LoganDickon/FilterCheck/README.md

# FilterCheck
This repository contains all required documents on the "FilterCheck"

Created: 5/3/2022                                                                                                                                                        
Property of AtorLabs
