LoganDickon/FilterCheck/Documents/README.md

# This folder contains "FilterCheck Documents" (.XLSX, .DOC)
