LoganDickon/FilterCheck/Mechanical/Interface Panel Decal/readme.md

# This Folder contains the FilterCheck interface panel decal
