LoganDickon/FilterCheck/Mechanical/Machine Shop Files/readme.md

# This folder contains the file for the FilterCheck interface panel cutout
