LoganDickon/FilterCheck/Documents/FilterCheck - Electric Schematics (Title Page).docx

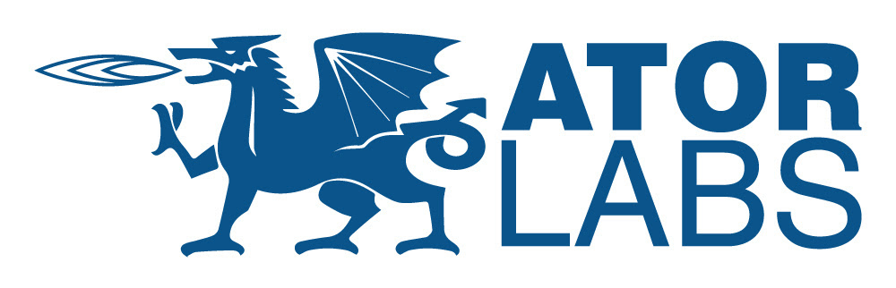
[picture p1: figure]

Memo 111422

FilterCheck

Electrical Schematics

7506 Holley Circle

Panama City Beach, FL 32408

November 14^t^h, 2022

# Revision Table

Date | Revision Number | Change Description | Job Title | Initials
11/14/2022 | 0 | Document Created | Electrical Engineer | JAD
