LoganDickon/FilterCheck/Documents/FilterCheck - Software (Title Page).docx

SFC 112222

FilterCheck

Software Flow Chart

7506 Holley Circle

Panama City Beach, FL 32408

November 22nd, 2022

# Revision Table

Date | Revision Number | Change Description | Job Title | Initials
10/19/2022 | 0 | Document Created | Software Engineer | LAD

Rev 0 Page 3

SFC 112222 ATOR LABS
