LoganDickon/FilterCheck/Mechanical/README.md

# This folder contains all FilterCheck Mechanical Documentation!

Created: 5/3/2022                                                                                                                                                         
Developers: Ben Morrisey (Mechanical Engineer) & Jake Cornman (Mechanical Engineer)                                                                                       
Property of AtorLabs
