LoganDickon/FilterCheck/Electrical/README.md

# This folder contains all FilterCheck Electrical Documentation!

Created: 5/3/2022                                                                                                                                                         
Developer: Jesse Dickon (Electrical Engineer)                                                                                                                           
Property of AtorLabs
