LoganDickon/FilterCheck/Software/Previous Versions/README.md

# Deprecated Arduino IDE code for the FilterCheck!
