LoganDickon/FilterCheck/Mechanical/SolidWorks Bill of Material/readme.md

# This file contains the Bill of Materials generated by SolidWorks 3D
