LoganDickon/FilterCheck/Documents/FilterCheck - Bill of Materials (Title Page).docx

Memo 10122

FilterCheck

Bill of Materials

7506 Holley Circle

Panama City Beach, FL 32408

October 1st, 2022

# Revision Table

Date | Revision Number | Change Description | Job Title | Initials
10/1/2022 | 0 | Document Created | Software Engineer | LAD
