LoganDickon/FilterCheck/Documents/FilterCheck - Bill of Materials (Printable).xlsx

ITEM NO. | A, B, or C | DEPARTMENT | PART NO. | DESCRIPTION | ASM CATEGORY | MATERIAL | MANUFACTURER | SUPPLIER | ORDER QTY. | COMP COSTS | BUILD QTY. | UNIT COST | 5 UNITS | 50 UNITS
1 | COTS | MECHANICAL | 1400 | PELICAN 1400 PROTECTOR CASE | CASE | POLYPROPYLENE | PELICAN | AMAZON | 1 | $89.92 | 1 | $89.92 | $449.60 | $4496.00
2 | COTS | MECHANICAL | 1400PF | PELICAN 1400 FRAME KIT | CASE | POLYPROPYLENE |  | MIDWEST CASE COMPANY | 1 | $26.95 | 1 | $26.95 | $134.75 | $1347.50
3 | COTS | MECHANICAL | 9307K73 | 7/8" GROMMET WITH 1-1/4" HOLE | CASE | BUNA-N RUBBER |  | MCMASTER-CARR | 25 | $12.99 | 1 | $0.52 | $2.60 | $25.98
4 | BESPOKE | MECHANICAL | FC-001 | CONTROL PANEL | CASE | ABS |  | ATOR LABS | 1 | $0.00 | 1 | $0.00 | $0.00 | $0.00
5 | BESPOKE | MECHANICAL | FC-007 | DECAL | CASE | VINYL |  | ATOR LABS | 1 | $0.00 | 1 | $0.00 | $0.00 | $0.00
6 | BESPOKE | MECHANICAL | FC-008 | CASE JIG FOR DRILLING | CASE | PLA |  | ATOR LABS | 1 | $0.00 | 1 | $0.00 | $0.00 | $0.00
7 | COTS | MECHANICAL | 99186A143 | RUBBER WASHER - 44mm OD, 25mm ID | FLOW SYSTEM | EPDM RUBBER |  | MCMASTER-CARR | 10 | $14.02 | 1 | $1.40 | $7.01 | $70.10
8 | COTS | MECHANICAL | 9540K747 | UNTHREADED BUMPER | FLOW SYSTEM | SBR RUBBER |  | MCMASTER-CARR | 10 | $6.33 | 3 | $1.90 | $9.50 | $94.95
9 | COTS | MECHANICAL | 2930T55 | STEEL WIRE CLOTH DISCS | FLOW SYSTEM | 316 STAINLESS STEEL |  | MCMASTER-CARR | 10 | $12.76 | 1 | $1.28 | $6.38 | $63.80
10 | COTS | MECHANICAL | 5300-IF-LP | TSI 5300 SERIES INLET FILTER | FLOW SYSTEM |  |  | TSI | 1 | $0.00 | 1 | $0.00 | $0.00 | $0.00
11 | COTS | MECHANICAL | 5233K52 | SOFT TUBING - 50 ft | FLOW SYSTEM | PVC Plastic |  | MCMASTER-CARR | 1 | $11.00 | 0.03 | $0.33 | $1.65 | $16.50
12 | COTS | MECHANICAL | 9561K16 | -015 ORING, BUNA-N | FLOW SYSTEM | EPDM |  | MCMASTER-CARR | 25 | $2.86 | 1 | $0.11 | $0.57 | $5.72
13 | COTS | MECHANICAL | 9561K24 | -022 ORING | FLOW SYSTEM | EPDM |  | MCMASTER-CARR | 10 | $1.97 | 1 | $0.20 | $0.99 | $9.85
14 | COTS | ELECTRICAL | JYQD_V7.3E2 | 24v BLOWER CONTROL BOARD | FLOW SYSTEM |  | EBAY | TOP_ELECTRONIC1980_TECHWIN | 1 | $17.19 | 1 | $17.19 | $85.95 | $859.50
15 | COTS | ELECTRICAL | U65ML-024KS-5 | MICRONEL 250 LPM BLDC BLOWER | FLOW SYSTEM |  | MICRONEL | DIGIKEY | 1 | $98.00 | 1 | $98.00 | $490.00 | $4900.00
16 | COTS | ELECTRICAL | 5310-2 | TSI 5310 FLOW METER | FLOW SYSTEM | POLYCARBONATE |  | TSI | 1 | $0.00 | 1 | $0.00 | $0.00 | $0.00
17 | COTS | ELECTRICAL | LR4P-USBMF | USB 3.0 ADAPTER | FLOW SYSTEM |  | WARMSTOR | AMAZON | 4 | $8.99 | 1 | $2.25 | $11.24 | $112.38
18 | COTS | ELECTRICAL | B07VJNQT6F | LOW PROFILE USB-C CABLE | FLOW SYSTEM |  | UGREEN | AMAZON | 1 | $8.49 | 1 | $8.49 | $42.45 | $424.50
19 | COTS | ELECTRICAL | B07RX7Z9ZW | 36 Pins .5mm Pitch 150mm FPC FFC | FLOW SYSTEM | PLASTIC | UXCELL | AMAZON | 5 | $6.99 | 1 | 1.398 | 6.99 | 69.9
20 | COTS | ELECTRICAL | a19042900ux0610 | 36 Pins to 36 Pins Extension Adapter .5mm Pitch | FLOW SYSTEM | PLASTIC | UXCELL | UXCELL | 1 | $5.99 | 1 | 5.99 | 29.95 | 299.5
21 | BESPOKE | MECHANICAL | FC-003 | PITOT TOP | FLOW SYSTEM | SLA |  | ATOR LABS | 1 | $0.00 | 1 | $0.00 | $0.00 | $0.00
22 | BESPOKE | MECHANICAL | FC-004 | PITOT BOTTOM | FLOW SYSTEM | SLA/PLA |  | ATOR LABS | 1 | $0.00 | 1 | $0.00 | $0.00 | $0.00
23 | BESPOKE | MECHANICAL | FC-005 | ADAPTER, BLDC FAN TO FILTER | FLOW SYSTEM | SLA |  | ATOR LABS | 1 | $0.00 | 1 | $0.00 | $0.00 | $0.00
24 | BESPOKE | MECHANICAL | FC-006 | VERIFICATION ORIFICE A | FLOW SYSTEM | SLA |  | ATOR LABS | 1 | $0.00 | 1 | $0.00 | $0.00 | $0.00
25 | BESPOKE | MECHANICAL | FC-009 | DISPLAY HOLDER | FLOW SYSTEM | SLA |  | ATOR LABS | 1 | $0.00 | 1 | $0.00 | $0.00 | $0.00
26 | COTS | ELECTRICAL | 7395K11 | ROCKER POWER SWITCH | POWER | PLASTIC |  | MCMASTER-CARR | 1 | $7.50 | 1 | $7.50 | $37.50 | $375.00
27 | COTS | ELECTRICAL | 9397K15 | SOLDER-LOADED HEAT-SHRINK QUICK-DISCONNECT TERMINALS | POWER | POLYOLEFIN |  | MCMASTER-CARR | 10 | $13.40 | 2 | $2.68 | $13.40 | $134.00
28 | COTS | ELECTRICAL | B08P5PJBCM | 5.5MM X 2.1MM DC JACK, POWER INLET | POWER |  | QOFOWIN | AMAZON | 5 | $8.99 | 1 | $1.80 | $8.99 | $89.90
29 | COTS | ELECTRICAL | CU-J294 | 3000 MAH LIFEPO4 BATTERY (16 X 18650 BATTERIES) OPEN END WIRES | POWER | LIFEPO4 | AA PORTABLE POWER CORP | BATTERYSPACE | 1 | $102.77 | 1 | $102.77 | $513.85 | $5138.50
30 | COTS | ELECTRICAL | OWA-60U-30 | 30V POWER SUPPLY | POWER |  | MEANWELL | TRC ELECTRONICS | 1 | $32.30 | 1 | $32.30 | $161.50 | $1615.00
31 | COTS | ELECTRICAL | PSE-24-DC12-40 | 24V POWER CONVERTER | POWER | PLASTIC RESIN | RHINO | AUTOMATION DIRECT | 1 | $80.00 | 1 | $80.00 | $400.00 | $4000.00
32 | COTS | ELECTRICAL | LTC0389-X | POWER CONVERTER, 24V TO 5V | POWER / BOARD STACK |  | TOBSUN | AMAZON | 1 | $9.59 | 1 | $9.59 | $47.95 | $479.50
33 | COTS | ELECTRICAL | B07B48CW3Y | BATTERY RELAY | POWER / BOARD STACK |  | WALFRONT | AMAZON | 1 | $9.83 | 1 | $9.83 | $49.15 | $491.50
34 | COTS | ELECTRICAL | 43201513 | TEENSY 4.1 TERMINAL BOARD | BOARD STACK |  | OONO | AMAZON | 1 | $23.90 | 1 | $23.90 | $119.50 | $1195.00
35 | COTS | ELECTRICAL | TEENSY41 | TEENSY 4.1 DEVELOPMENT BOARD | BOARD STACK |  | TEENSY | PJRC | 1 | $32.60 | 1 | $32.60 | $163.00 | $1630.00
36 | COTS | ELECTRICAL | B079FGPC9Y | 5V 2 CHANNEL RELAY MODULE | BOARD STACK |  | CHENBO | AMAZON | 2 | $8.99 | 1 | $4.50 | $22.48 | $224.75
37 | COTS | ELECTRICAL | FAFEICYA6I34V0OPM | 3.3V PWM SIGNAL TO 0-5V VOLTAGE CONVERTER | BOARD STACK |  | FAFEICY | AMAZON | 1 | $7.12 | 1 | $7.12 | $35.60 | $356.00
38 | COTS | ELECTRICAL | B08G4VCQ84 | BLUE PANEL MOUNT LED | BOARD STACK |  | CHANZON | AMAZON | 5 | $5.99 | 1 | $1.20 | $5.99 | $59.90
39 | COTS | ELECTRICAL | B08G4XRKRX | GREEN PANEL MOUNT LED | BOARD STACK |  | CHANZON | AMAZON | 5 | $5.99 | 1 | $1.20 | $5.99 | $59.90
40 | COTS | ELECTRICAL | DT-6560-1.8m | USB TO TTL SERIAL 3.3V ADAPTER CABLE | BOARD STACK |  | DTECH | AMAZON | 1 | $15.68 | 1 | $15.68 | $78.40 | $784.00
41 | BESPOKE | MECHANICAL | FC-002-1 | STACKING BOARD - MOTOR CONTROLLER & BATTERY RELAY | BOARD STACK | PLA |  | ATOR LABS | 1 | $0.00 | 1 | $0.00 | $0.00 | $0.00
42 | BESPOKE | MECHANICAL | FC-002-2 | STACKING BOARD - TEENSY 4.1 TERMINAL BOARD | BOARD STACK | PLA |  | ATOR LABS | 1 | $0.00 | 1 | $0.00 | $0.00 | $0.00
43 | BESPOKE | MECHANICAL | FC-002-3 | STACKING BOARD - PWM TO ANALOG CONVERTER | BOARD STACK | PLA |  | ATOR LABS | 1 | $0.00 | 1 | $0.00 | $0.00 | $0.00
44 | COTS | MECHANICAL | 9273K15 | VELCRO STRIPS - 5 ft | FASTENER | NYLON |  | MCMASTER-CARR | 12 | $13.73 | 0.1 | $0.11 | $0.57 | $5.72
45 | COTS | MECHANICAL | 91771A943 | FLAT HEAD SCREW - #6-32x7/16" | FASTENER | 18-8 STAINLESS STEEL |  | MCMASTER-CARR | 100 | $10.64 | 10 | $1.06 | $5.32 | $53.20
46 | COTS | MECHANICAL | 98952A120 | M/F STANDOFF - M3x25mm + 5mm | FASTENER | ALUMINUM |  | MCMASTER-CARR | 1 | $2.24 | 3 | $6.72 | $33.60 | $336.00
47 | COTS | MECHANICAL | 95947A063 | F STANDOFF - M3x31MM | FASTENER | AL 6061-T6 |  | MCMASTER-CARR | 1 | $2.23 | 4 | $8.92 | $44.60 | $446.00
48 | COTS | MECHANICAL | 93657A207 | SPACER - M3x5mm | FASTENER | NYLON 6/6 PLASTIC |  | MCMASTER-CARR | 1 | $1.39 | 4 | $5.56 | $27.80 | $278.00
49 | COTS | MECHANICAL | 93475A210 | WASHER - M3 | FASTENER | 18-8 STAINLESS STEEL |  | MCMASTER-CARR | 100 | $2.19 | 4 | $0.09 | $0.44 | $4.38
50 | COTS | MECHANICAL | B073XP7MZ6 | M/F STANDOFF - M3x10mm + 6mm | FASTENER | BRASS | SAMIDEA | AMAZON | 50 | $6.99 | 10 | $1.40 | $6.99 | $69.90
51 | COTS | MECHANICAL | 95947A510 | F STANDOFF - M3x13mm | FASTENER | ALUMINUM |  | MCMASTER-CARR | 1 | $1.15 | 2 | $2.30 | $11.50 | $115.00
52 | COTS | MECHANICAL | B09V2936PG | F STANDOFF - M3x15mm | FASTENER | BRASS | PRIAOLKER | AMAZON | 20 | $5.99 | 4 | $1.20 | $5.99 | $59.90
53 | COTS | MECHANICAL | B09NDGJC3F | F STANDOFF - M3x20mm | FASTENER | BRASS | PRIAOLKER | AMAZON | 20 | $7.99 | 2 | $0.80 | $4.00 | $39.95
54 | COTS | MECHANICAL | 95947A527 | F STANDOFF - M3x24mm | FASTENER | ALUMINUM |  | MCMASTER-CARR | 1 | $1.85 | 8 | $14.80 | $74.00 | $740.00
55 | COTS | MECHANICAL | 91828A211 | HEX NUT - M3 | FASTENER | 18-8 STAINLESS STEEL |  | MCMASTER-CARR | 100 | $4.73 | 6 | $0.28 | $1.42 | $14.19
56 | COTS | MECHANICAL | 90116A153 | PAN HEAD SCREW - M3x8mm | FASTENER | 316 STAINLESS STEEL |  | MCMASTER-CARR | 100 | $13.24 | 16 | $2.12 | $10.59 | $105.92
57 | COTS | MECHANICAL | 90116A157 | PAN HEAD SCREW - M3x12mm | FASTENER | 316 STAINLESS STEEL |  | MCMASTER-CARR | 100 | $11.52 | 6 | $0.69 | $3.46 | $34.56
58 | COTS | MECHANICAL | 92010A118 | FLAT HEAD SCREW - M3x8mm | FASTENER | 18-8 STAINLESS STEEL |  | MCMASTER-CARR | 100 | $5.52 | 16 | $0.88 | $4.42 | $44.16
59 | COTS | MECHANICAL | 92010A122 | FLAT HEAD SCREW - M3x12mm | FASTENER | 18-8 STAINLESS STEEL |  | MCMASTER-CARR | 100 | $6.04 | 16 | $0.97 | $4.83 | $48.32
60 | BESPOKE | MECHANICAL | FC-010 | MOLD FOR BLDC INLET GASKET - 1" OD | RAW MATERIALS | SILICONE |  | ATOR LABS | 1 | $0.00 | 1 | $0.00 | $0.00 | $0.00
61 | BESPOKE | MECHANICAL | FC-011 | MOLD FOR FLOW METER OUTLET PLUG | RAW MATERIALS | SILICONE |  | ATOR LABS | 1 | $0.00 | 1 | $0.00 | $0.00 | $0.00
62 | COTS | MECHANICAL | 8586K261 | SHEET OF ABS 24" x 48" | RAW MATERIALS | ABS |  | MCMASTER-CARR | 1 | $30.30 | 2 | $60.60 | $303.00 | $3030.00
63 | COTS | MECHANICAL | B08T1HSPM2 | 1 KG BOTTLE OF SLA RESIN | RAW MATERIALS | SLA | ELEGOO | AMAZON | 1 | $24.99 | 0.5 | $12.49 | $62.47 | $624.75
64 | COTS | ELECTRICAL | CAB-14574 | OPEN-LEADED 2-WIRE MOLEX CONNECTOR | RAW MATERIALS | WIRE | CAB-14574 | DIGIKEY | 1 | $1.06 | 1 | $1.06 | $5.30 | $53.00
65 | COTS | ELECTRICAL | CAB-14575 | OPEN-LEADED 3-WIRE MOLEX CONNECTOR | RAW MATERIALS | WIRE | CAB-14575 | DIGIKEY | 1 | $1.56 | 1 | $1.56 | $7.80 | $78.00
66 | COTS | MECHANICAL | PLA175BK1000 | 1 KG SPOOL OF PLA | RAW MATERIALS | PLA | AMAZON BASICS | AMAZON | 1 | $22.76 | 0.5 | $11.38 | $56.90 | $569.00
67 | COTS | ELECTRICAL | SW16A252008F25C5_RBWBBG | 16-GAUGE WIRE, RED BLACK WHITE BLUE GREEN, 25FT EA | RAW MATERIALS | WIRE | BNTECHGO | AMAZON | 1 | $35.98 | 1 | $35.98 | $179.90 | $1799.00
68 | COTS | ELECTRICAL | SW22A60008F30C10 | 22-GAUGE WIRE, 10 COLORS, 30FT EA | RAW MATERIALS | WIRE | BNTECHGO | AMAZON | 1 | $25.98 | 1 | $25.98 | $129.90 | $1299.00
69 | COTS | MECHANICAL | B09J22NWMF | 1-1/4" FORSTNER DRILL BIT | TOOLING | STEEL | BAIDETS | AMAZON | 1 | $13.58 | 1 | $13.58 | $13.58 | $13.58
70 | COTS | MECHANICAL | ‎FSF-004110 | 11mm or 27/64" DRILL BIT | TOOLING |  | FISCH | AMAZON | 1 | $5.99 | 1 | $5.99 | $5.99 | $5.99
 |  |  |  |  |  |  |  |  |  | COMP TOTAL |  | UNIT TOTAL | 5 UNITS | 50 UNITS
 |  |  |  |  |  |  |  |  |  | $929.17 |  | $785.54 | $3927.71 | $39277.08
 |  |  |  |  | `
