LoganDickon/FilterCheck/Mechanical/SolidWorks Assembly Files/FC-ControlBoardStackAsm.SLDASM

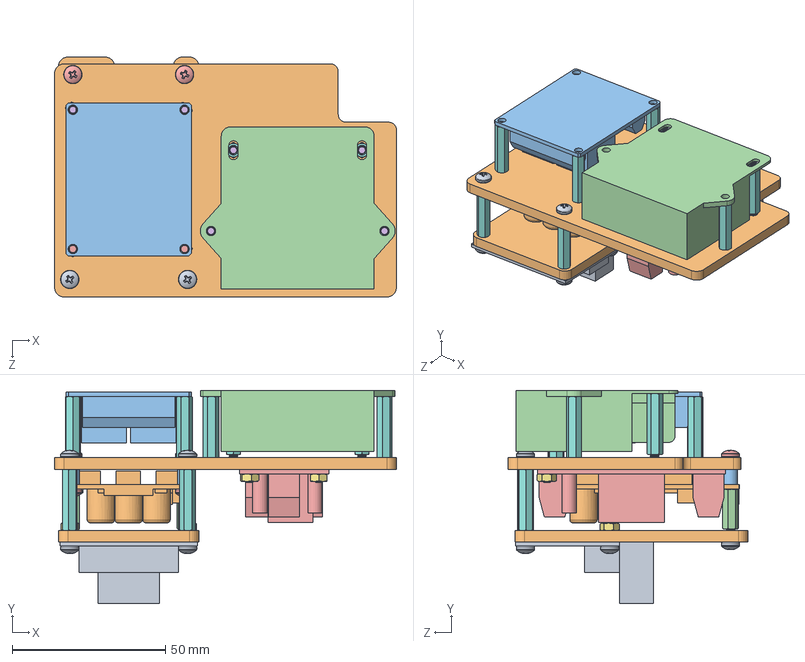
[picture p2: CAD file, 2022-12-27]
Mechanical/SolidWorks Assembly Files/FC-ControlBoardStackAsm.SLDASM
111.8 x 69.7 x 78.5 mm
FC-002_STACKING BOARDS x 2
JDQ_2 channel relay
LTC0389-X_Tobsun 24V to 5V
B07B48CW3Y_Walfront_Battery Relay
92010A118_Passivated 18-8 Stainless Steel Phillips Flat Head Screw x 8
91828A211_18-8 Stainless Steel Hex Nut x 4
Fafeicya6i34v0opm_PWM to Analog
95947A016_McMaster_M3 x 20mm standoff x 10
90116A153_McMaster_M3 x 8mm Screws x 8
TF037-1001-D_Nidec_Blower Control Board
93657A207_McMaster_M3 x 5mm Spacer x 4
95947A510_McMaster_M3 x 13mm spacer x 2
90116A157_316 Stainless Steel Pan Head Phillips Screws x 4
