LoganDickon/FilterCheck/Mechanical/stuff/DC Power Plug 2.1x5.5mm ASSY.SLDPRT

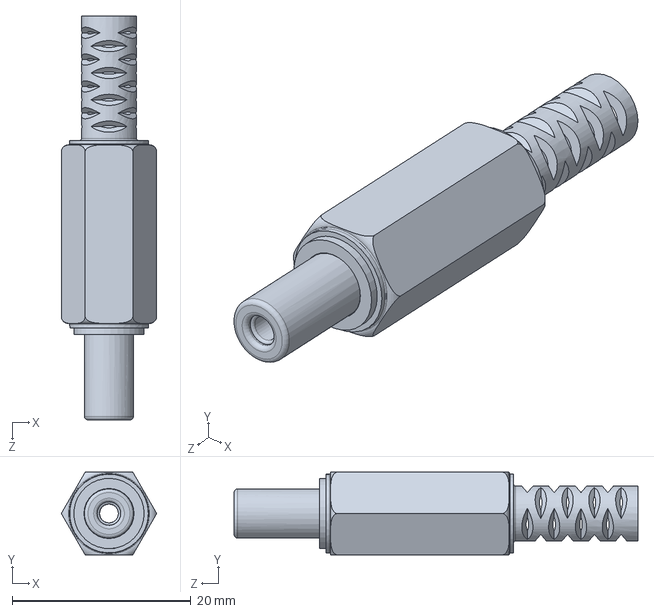
[picture p3: CAD file, 2022-12-27]
Mechanical/stuff/DC Power Plug 2.1x5.5mm ASSY.SLDPRT
10.7 x 9.25 x 45.2 mm
