LoganDickon/FilterCheck/Mechanical/stuff/FC-004_Micronel CLAMP PLATE.SLDPRT

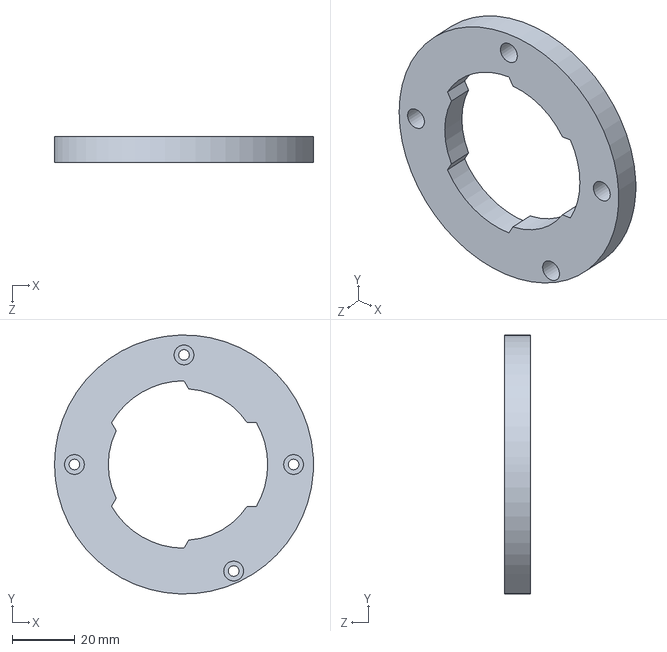
[picture p4: CAD file, 2022-12-27]
Mechanical/stuff/FC-004_Micronel CLAMP PLATE.SLDPRT
82.5 x 82.5 x 8.26 mm
