LoganDickon/FilterCheck/Mechanical/SolidWorks Part Files/B08P5PJBCM_Qofowin_5_5mm x 2_1mm DC jack.SLDPRT

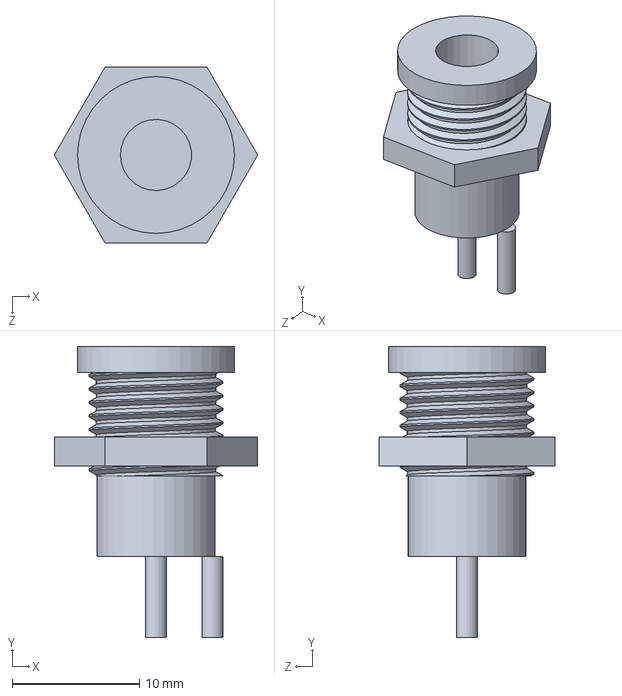
[picture p5: CAD file, 2022-12-27]
Mechanical/SolidWorks Part Files/B08P5PJBCM_Qofowin_5_5mm x 2_1mm DC jack.SLDPRT
16.0 x 22.9 x 13.8 mm
