LoganDickon/FilterCheck/Mechanical/stuff/Display.SLDPRT

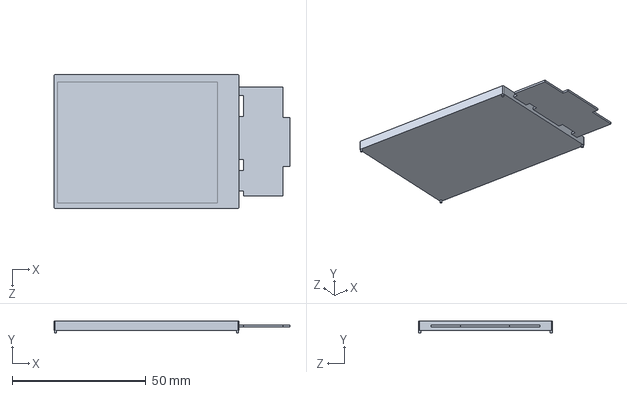
[picture p6: CAD file, 2022-12-27]
Mechanical/stuff/Display.SLDPRT
88.1 x 4.32 x 49.9 mm
