LoganDickon/FilterCheck/Mechanical/stuff/U65ML-024KS-5_Simple.SLDPRT

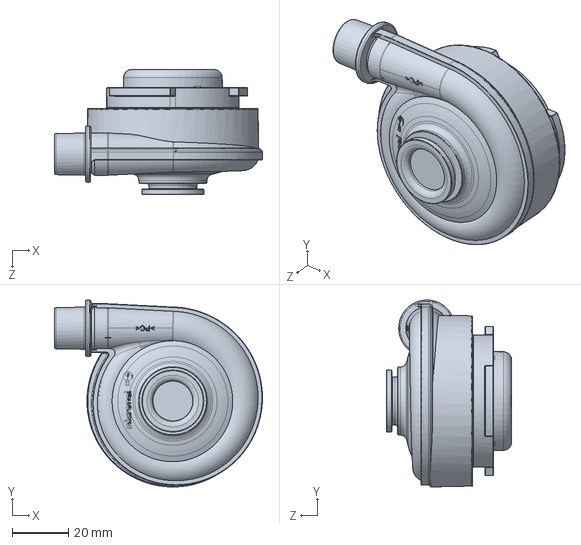
[picture p7: CAD file, 2022-12-27]
Mechanical/stuff/U65ML-024KS-5_Simple.SLDPRT
73.8 x 66.3 x 44.5 mm
