LoganDickon/FilterCheck/Mechanical/stuff/USB 3_0 Angle Adapter.SLDPRT

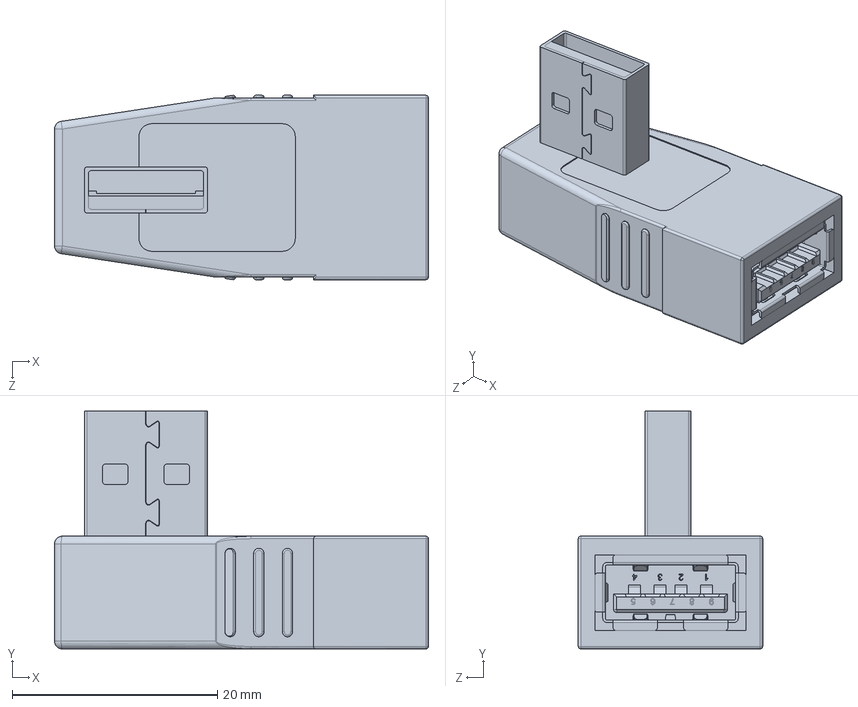
[picture p8: CAD file, 2022-12-27]
Mechanical/stuff/USB 3_0 Angle Adapter.SLDPRT
36.4 x 23.2 x 18.0 mm
