LoganDickon/FilterCheck/Mechanical/SolidWorks Part Files/120V Cable End.SLDPRT

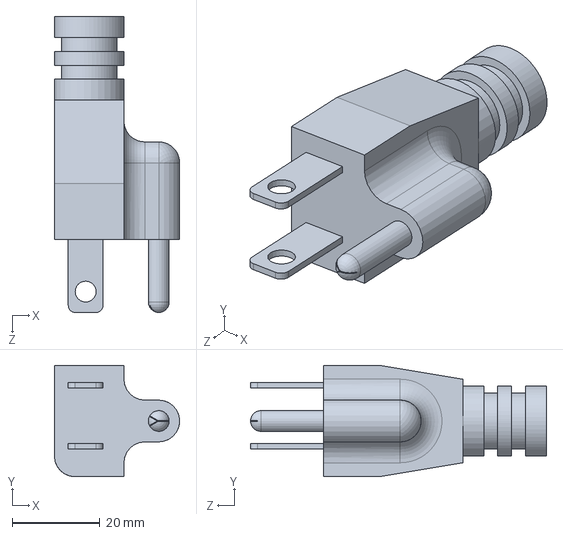
[picture p9: CAD file, 2022-12-27]
Mechanical/SolidWorks Part Files/120V Cable End.SLDPRT
28.6 x 25.4 x 67.5 mm
