LoganDickon/FilterCheck/Mechanical/stuff/LTC0389-X_Tobsun 24V to 5V.SLDPRT

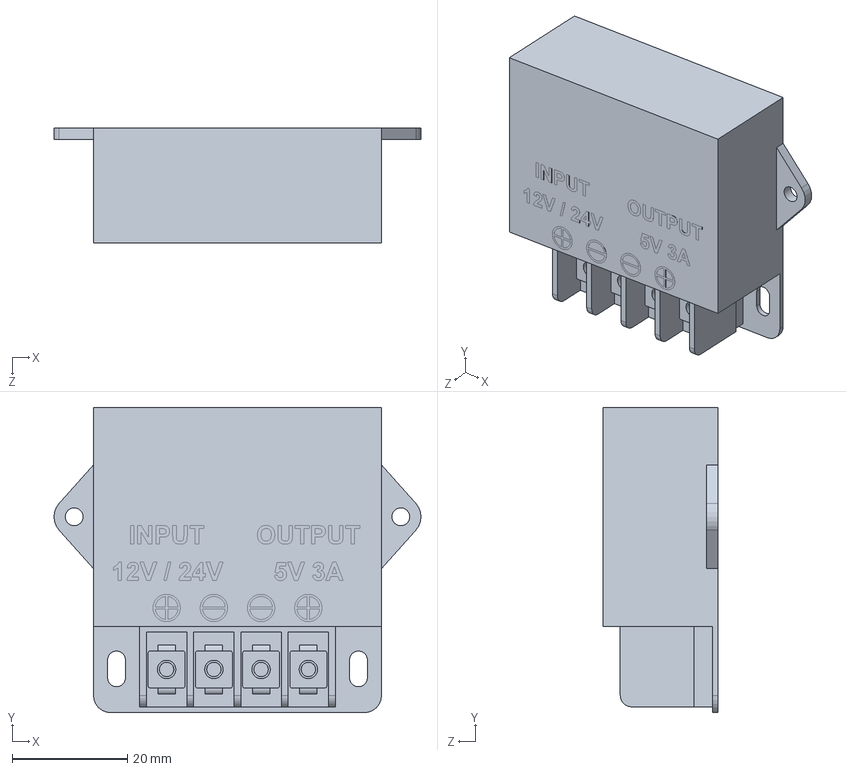
[picture p10: CAD file, 2022-12-27]
Mechanical/stuff/LTC0389-X_Tobsun 24V to 5V.SLDPRT
63.7 x 53.0 x 20.0 mm
