LoganDickon/FilterCheck/Mechanical/SolidWorks Part Files/Fafeicya6i34v0opm_PWM to Analog.SLDPRT

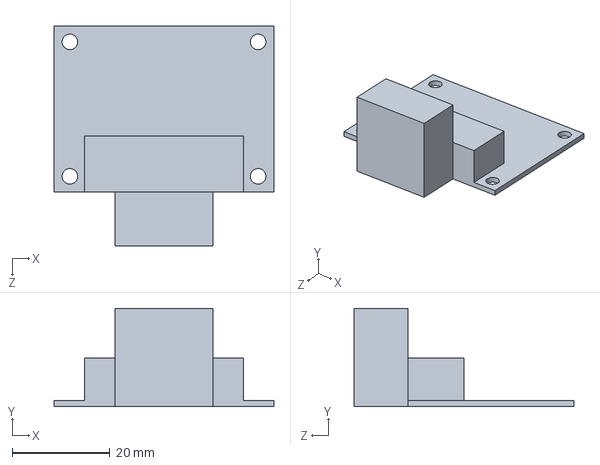
[picture p11: CAD file, 2022-12-27]
Mechanical/SolidWorks Part Files/Fafeicya6i34v0opm_PWM to Analog.SLDPRT
45.0 x 20.1 x 45.0 mm
