LoganDickon/FilterCheck/Mechanical/stuff/DT-6560-1_8m_DTECH_USB-TTL Adapter.SLDPRT

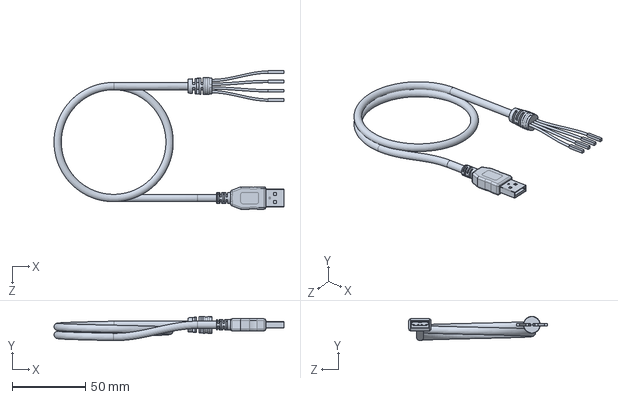
[picture p12: CAD file, 2022-12-27]
Mechanical/stuff/DT-6560-1_8m_DTECH_USB-TTL Adapter.SLDPRT
156.6 x 16.6 x 94.3 mm
