LoganDickon/FilterCheck/Mechanical/stuff/5ZSD8W-YT-12V_Chanzon_Panel Mount LED.SLDPRT

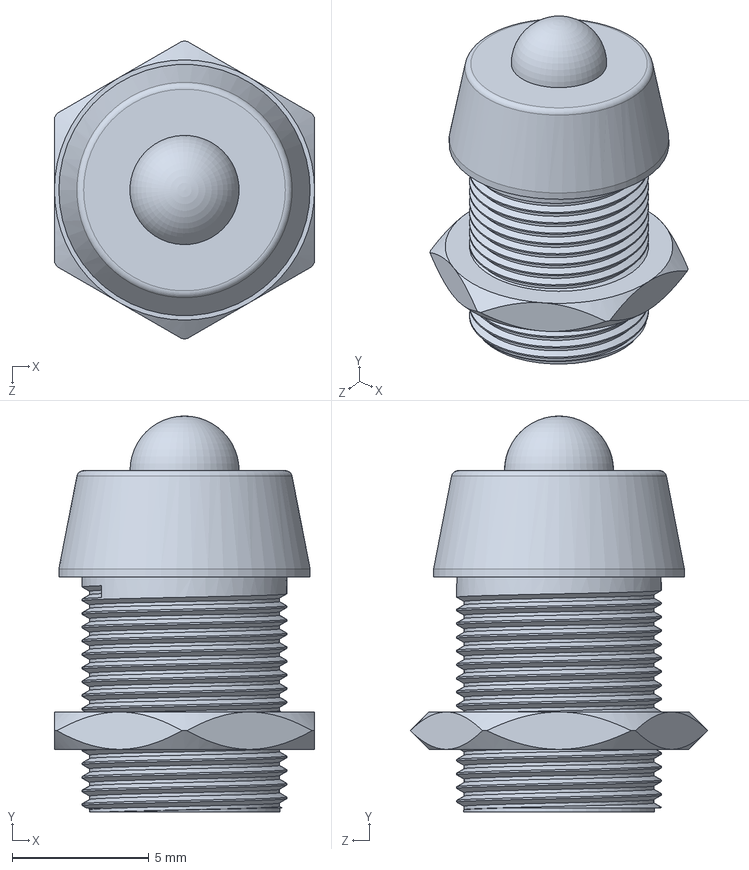
[picture p13: CAD file, 2022-12-27]
Mechanical/stuff/5ZSD8W-YT-12V_Chanzon_Panel Mount LED.SLDPRT
9.53 x 14.5 x 10.9 mm
