LoganDickon/FilterCheck/Mechanical/stuff/FC-002_STACKING BOARDS.SLDPRT

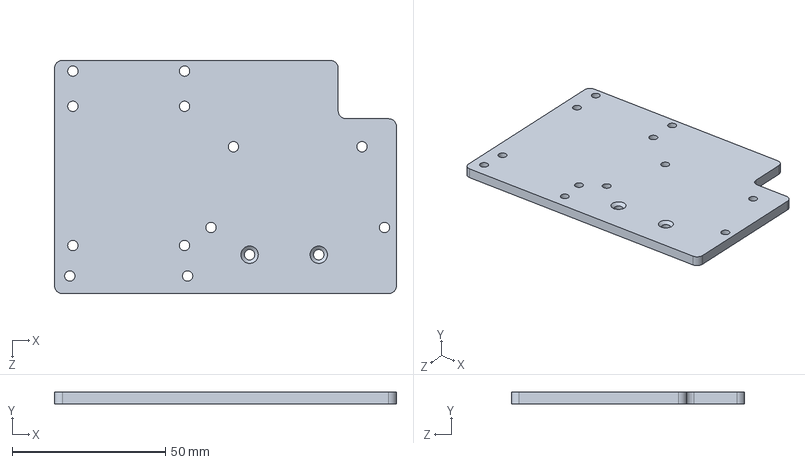
[picture p14: CAD file, 2022-12-27]
Mechanical/stuff/FC-002_STACKING BOARDS.SLDPRT
111.8 x 3.81 x 76.2 mm
