LoganDickon/FilterCheck/Mechanical/stuff/Teensy 3pt5 Terminal Board.SLDPRT

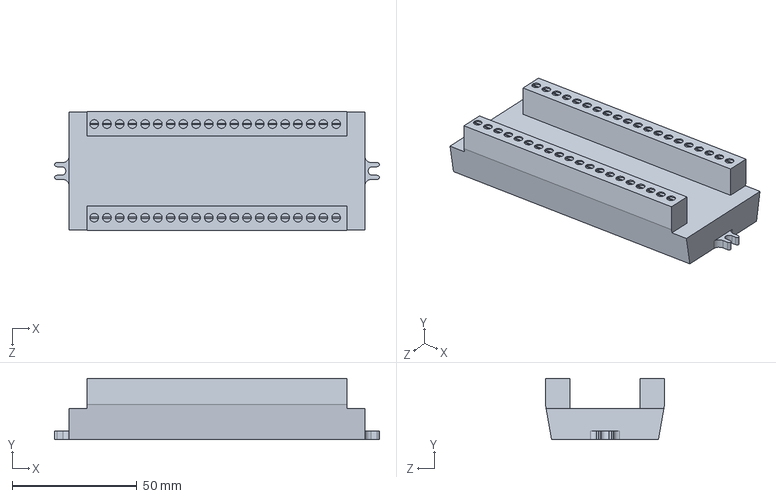
[picture p15: CAD file, 2022-12-27]
Mechanical/stuff/Teensy 3pt5 Terminal Board.SLDPRT
130.2 x 24.6 x 47.8 mm
