LoganDickon/FilterCheck/Mechanical/stuff/FC-005_BLDC Fan to Filter Adapter.SLDPRT

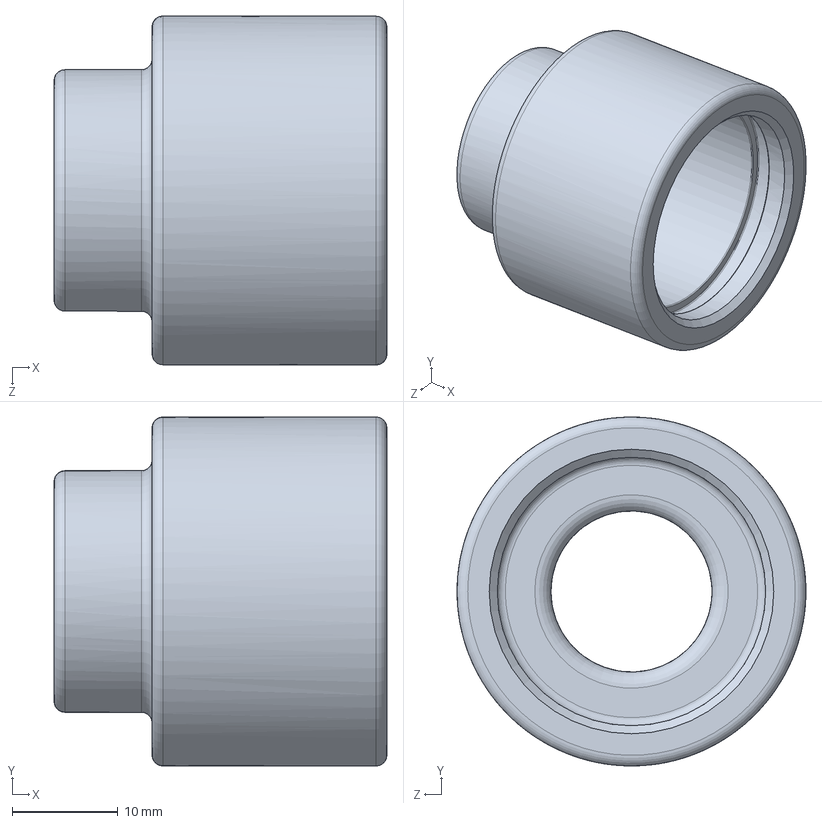
[picture p16: CAD file, 2022-12-27]
Mechanical/stuff/FC-005_BLDC Fan to Filter Adapter.SLDPRT
31.5 x 33.0 x 33.0 mm
