LoganDickon/FilterCheck/Mechanical/SolidWorks Part Files/FC-001_Cover Plate_Peli 1400.SLDPRT

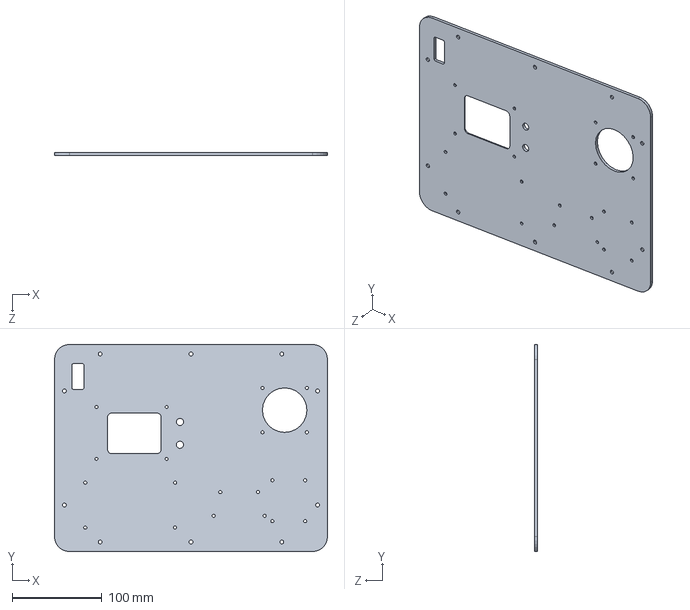
[picture p17: CAD file, 2022-12-27]
Mechanical/SolidWorks Part Files/FC-001_Cover Plate_Peli 1400.SLDPRT
303.9 x 230.5 x 3.17 mm
