LoganDickon/FilterCheck/Mechanical/SolidWorks Part Files/PSE-24-DC12-40_RHINO DC Power Supply.SLDPRT

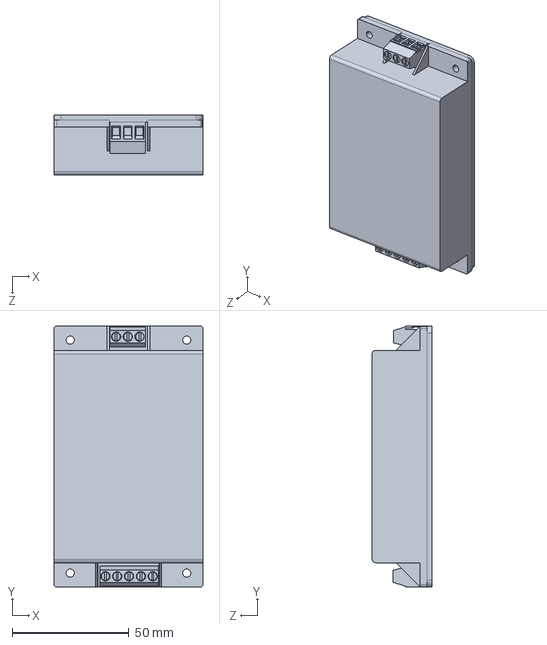
[picture p18: CAD file, 2022-12-27]
Mechanical/SolidWorks Part Files/PSE-24-DC12-40_RHINO DC Power Supply.SLDPRT
63.8 x 112.0 x 25.6 mm
