LoganDickon/FilterCheck/Mechanical/SolidWorks Part Files/Battery.SLDPRT

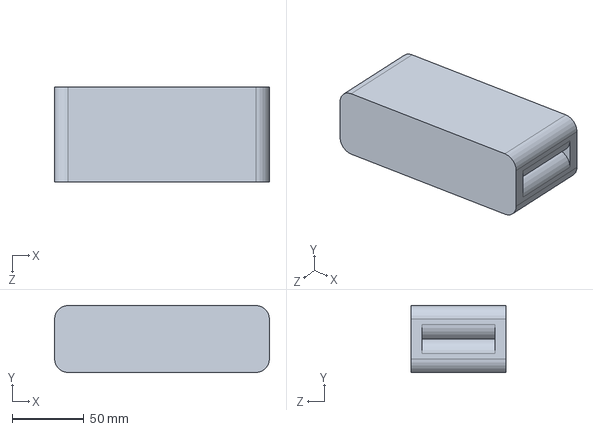
[picture p19: CAD file, 2022-12-27]
Mechanical/SolidWorks Part Files/Battery.SLDPRT
149.4 x 46.6 x 66.0 mm
