LoganDickon/FilterCheck/Mechanical/stuff/Pre Filter for Flow MEter.SLDPRT

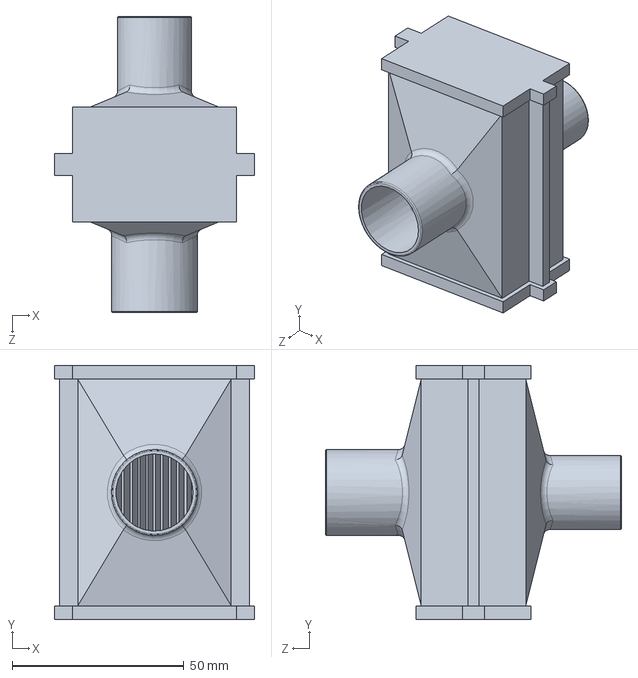
[picture p20: CAD file, 2022-12-27]
Mechanical/stuff/Pre Filter for Flow MEter.SLDPRT
58.4 x 74.0 x 86.4 mm
