LoganDickon/FilterCheck/Mechanical/SolidWorks Part Files/OWA-60U-30_Meanwell Power Cable.SLDPRT

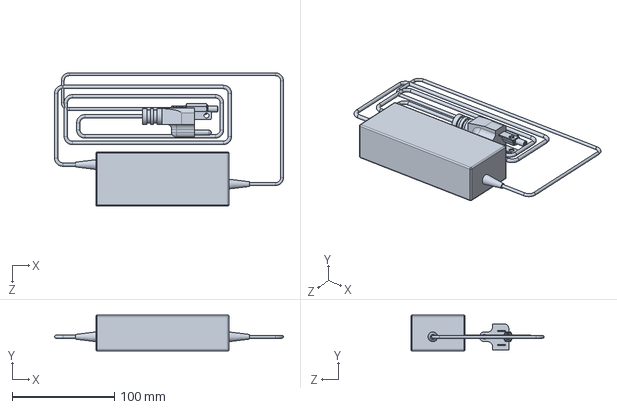
[picture p21: CAD file, 2022-12-27]
Mechanical/SolidWorks Part Files/OWA-60U-30_Meanwell Power Cable.SLDPRT
223.6 x 35.0 x 130.2 mm
