LoganDickon/FilterCheck/Mechanical/SolidWorks Part Files/FC-006_Verification Orifice.SLDPRT

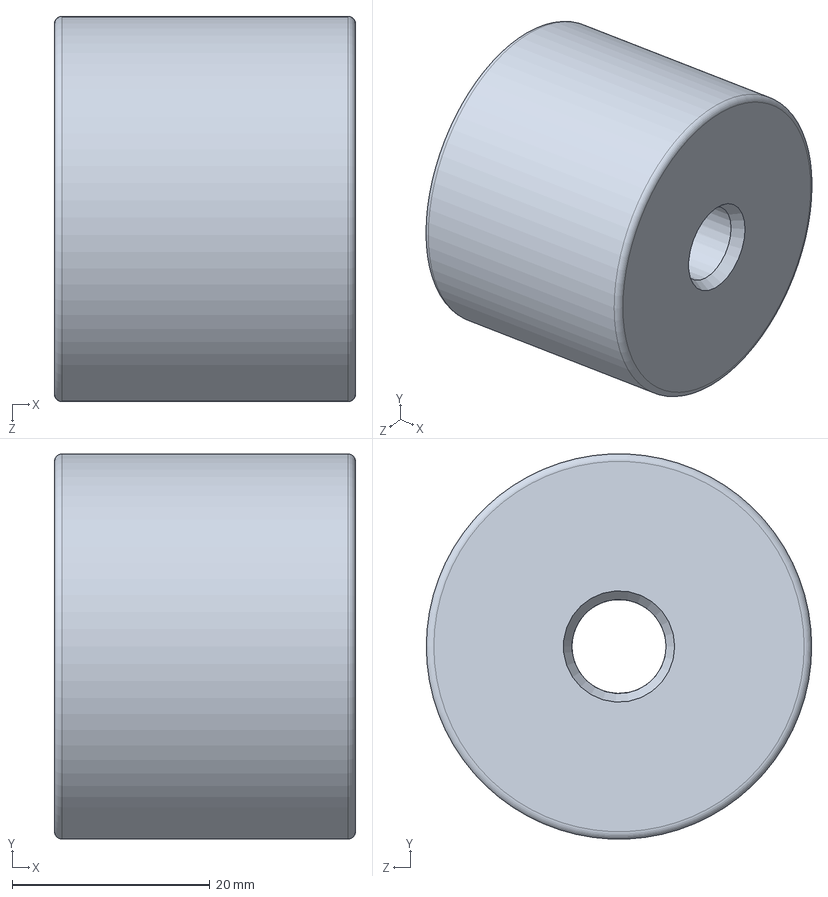
[picture p22: CAD file, 2022-12-27]
Mechanical/SolidWorks Part Files/FC-006_Verification Orifice.SLDPRT
30.5 x 38.9 x 39.0 mm
