LoganDickon/FilterCheck/Mechanical/stuff/FC-003_FC_PITOT Top FOR Micronel MOTOR.SLDPRT

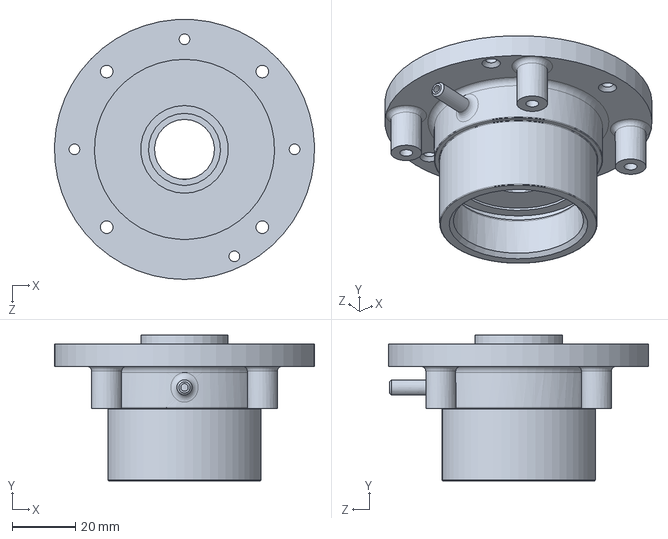
[picture p23: CAD file, 2022-12-27]
Mechanical/stuff/FC-003_FC_PITOT Top FOR Micronel MOTOR.SLDPRT
82.5 x 46.2 x 82.5 mm
