LoganDickon/FilterCheck/Mechanical/SolidWorks Part Files/UGREEN USB-C.stp.SLDPRT

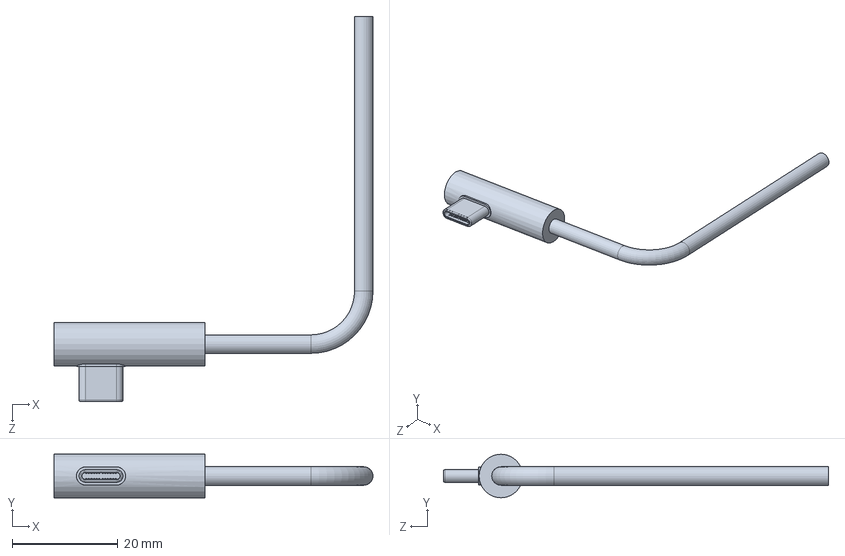
[picture p24: CAD file, 2022-12-27]
Mechanical/SolidWorks Part Files/UGREEN USB-C.stp.SLDPRT
60.3 x 8.26 x 72.8 mm
