LoganDickon/FilterCheck/Mechanical/stuff/B07B48CW3Y_Walfront_Battery Relay.SLDPRT

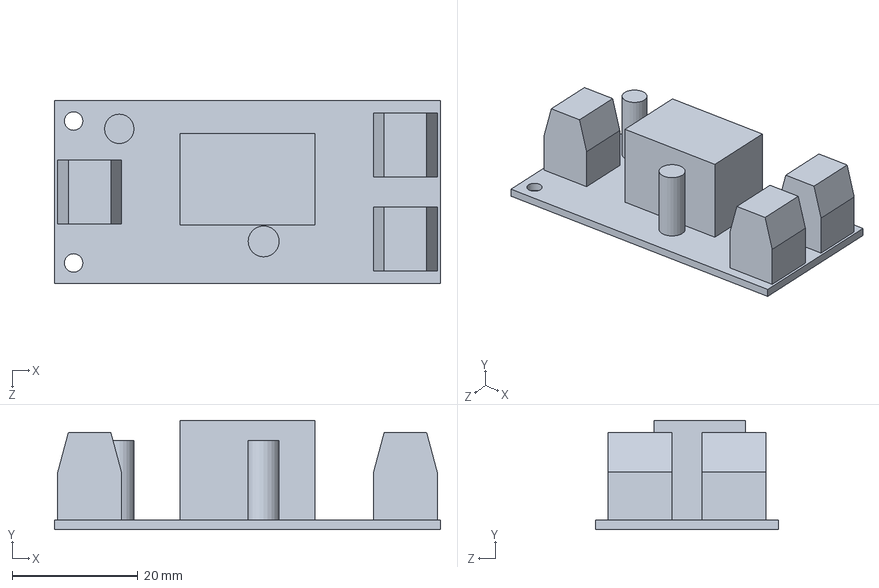
[picture p25: CAD file, 2022-12-27]
Mechanical/stuff/B07B48CW3Y_Walfront_Battery Relay.SLDPRT
61.5 x 17.4 x 29.2 mm
