LoganDickon/FilterCheck/Mechanical/SolidWorks Part Files/FC-001_Cover Plate_Peli 1400_Small Test Piece.SLDPRT

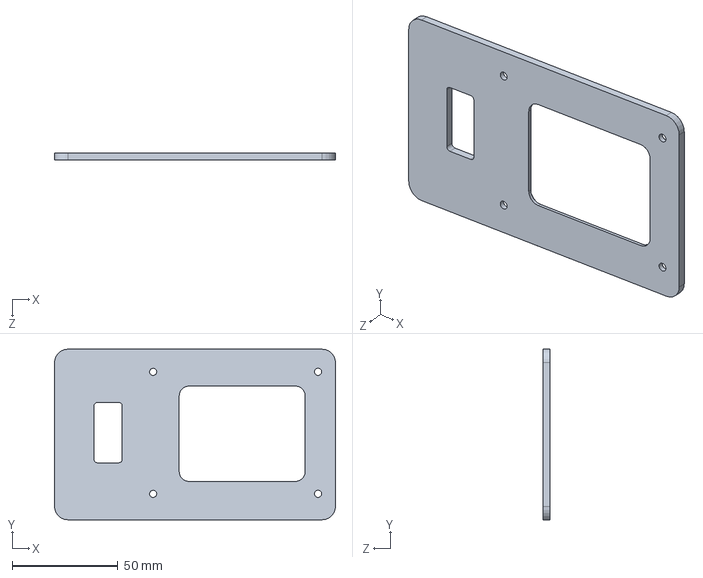
[picture p26: CAD file, 2022-12-27]
Mechanical/SolidWorks Part Files/FC-001_Cover Plate_Peli 1400_Small Test Piece.SLDPRT
133.1 x 80.8 x 3.17 mm
