LoganDickon/FilterCheck/Mechanical/SolidWorks Part Files/Display Holder-1.SLDPRT

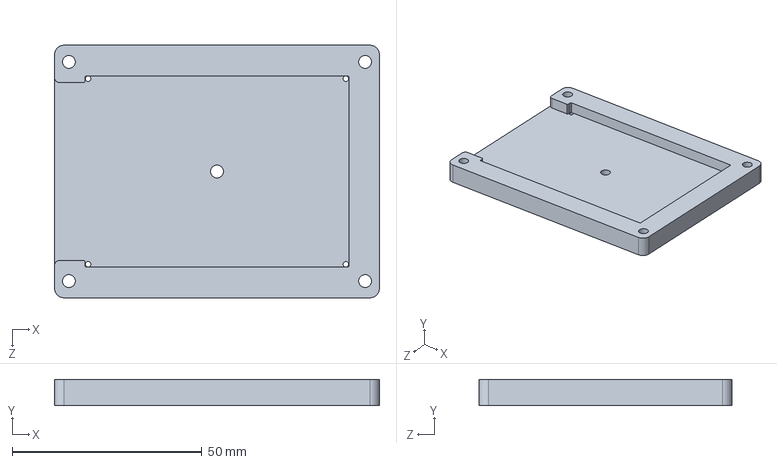
[picture p27: CAD file, 2022-12-27]
Mechanical/SolidWorks Part Files/Display Holder-1.SLDPRT
85.7 x 6.86 x 66.7 mm
