LoganDickon/FilterCheck/Mechanical/SolidWorks Part Files/TSI 5310_MASS FLOW METER.SLDPRT

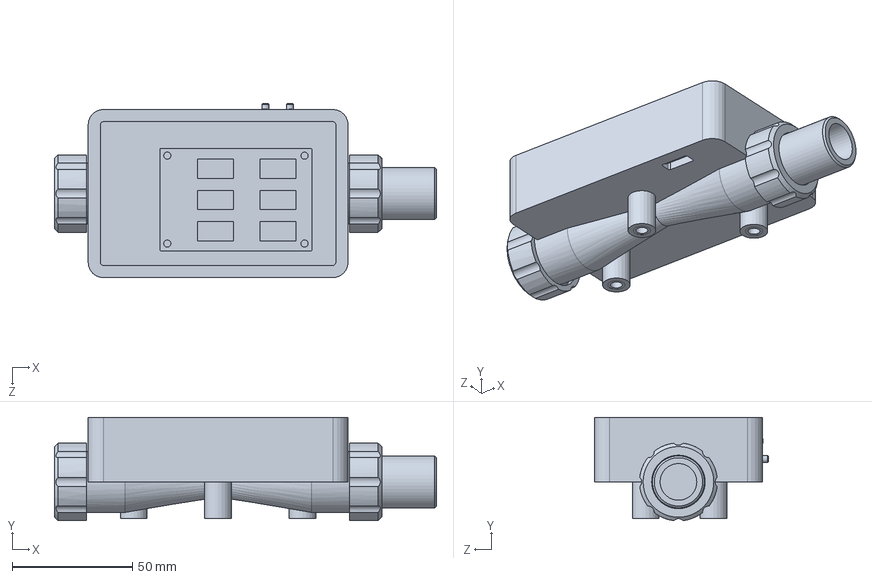
[picture p28: CAD file, 2022-12-27]
Mechanical/SolidWorks Part Files/TSI 5310_MASS FLOW METER.SLDPRT
158.6 x 42.9 x 72.4 mm
