LoganDickon/FilterCheck/Mechanical/SolidWorks Assembly Files/FC-BlwrAdptASM_Blower to Filter Asm.SLDASM

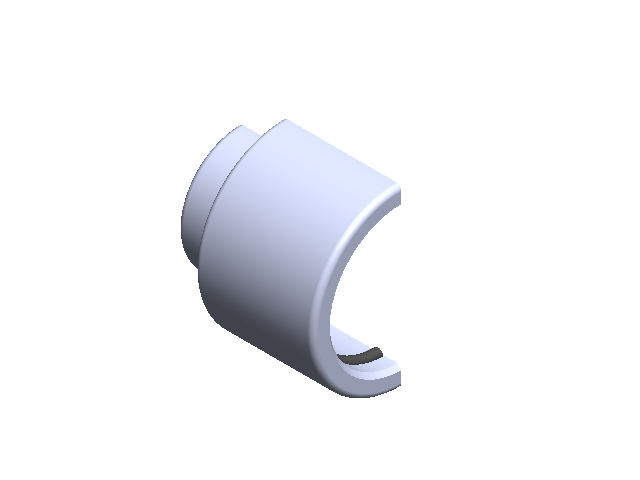
[picture p29: CAD file, 2022-12-27]
Mechanical/SolidWorks Assembly Files/FC-BlwrAdptASM_Blower to Filter Asm.SLDASM
FC-005_BLDC Fan to Filter Adapter
9561K16_McMAster_ -015 oring
9561K24_McMaster_ -022 oring
