LoganDickon/FilterCheck/(list of files, cad)

Other CAD files:
Mechanical/SolidWorks Part Files/SW22A60008F30C10_Amazon_22 Gauge Wire Kit.SLDPRT
Mechanical/stuff/SW22A60008F30C10_Amazon_22 Gauge Wire Kit.SLDPRT
Mechanical/SolidWorks Part Files/SW16A252008F25C5_RBWBBG_Amazon_16 Gauge Wire Kit.SLDPRT
Mechanical/stuff/SW16A252008F25C5_RBWBBG_Amazon_16 Gauge Wire Kit.SLDPRT
Mechanical/SolidWorks Drawing Files/1400_Pelican_Protector Case.SLDDRW
Mechanical/SolidWorks Drawing Files/FC-001_Cover Plate_Peli 1400.SLDDRW
Mechanical/SolidWorks Drawing Files/FC-002-1_MOTOR CONTROL BOARD.SLDDRW
Mechanical/SolidWorks Drawing Files/FC-002-2_TEENSY TERMINAL BOARD.SLDDRW
Mechanical/SolidWorks Drawing Files/FC-002-3_PWM TO ANALOG CONVERTER BOARD.SLDDRW
Mechanical/SolidWorks Drawing Files/FC-003_FC_PITOT Top FOR Micronel MOTOR.SLDDRW
Mechanical/SolidWorks Drawing Files/FC-004_Micronel CLAMP PLATE.SLDDRW
Mechanical/SolidWorks Drawing Files/FC-005_BLDC Fan to Filter Adapter.SLDDRW
Mechanical/SolidWorks Drawing Files/FC-006_Verification Orifice.SLDDRW
Mechanical/SolidWorks Part Files/2930T55_316 Stainless Steel Wire Cloth Discs.SLDPRT
Mechanical/SolidWorks Part Files/3645N11_Buna-N Gasket for John Perry Gasket Fittings.SLDPRT
Mechanical/SolidWorks Part Files/5233K66_MCMASTER_PVC tubing 1_8 inch.SLDPRT
Mechanical/SolidWorks Part Files/7395K11_McMaster_Power Switch.SLDPRT
Mechanical/SolidWorks Part Files/8761K11_USB 3.0 Adapter.SLDPRT
Mechanical/SolidWorks Part Files/90116A153_McMaster_M3 x 8mm Screws.SLDPRT
Mechanical/SolidWorks Part Files/90116A155_McMaster_M3 x 10mm pan head.SLDPRT
Mechanical/SolidWorks Part Files/90116A157_316 Stainless Steel Pan Head Phillips Screws.SLDPRT
Mechanical/SolidWorks Part Files/91771A943_MCMASTER_#6-32_7-16 LONG.SLDPRT
Mechanical/SolidWorks Part Files/91828A211_18-8 Stainless Steel Hex Nut.SLDPRT
Mechanical/SolidWorks Part Files/92010A118_Passivated 18-8 Stainless Steel Phillips Flat Head Screw.SLDPRT
Mechanical/SolidWorks Part Files/92010A122_Passivated 18-8 Stainless Steel Phillips Flat Head Screw.SLDPRT
Mechanical/SolidWorks Part Files/9273K15_McMaster_Velcro 1_5in.SLDPRT
Mechanical/SolidWorks Part Files/9307K73_Buna-N Rubber Grommets.SLDPRT
Mechanical/SolidWorks Part Files/93657A207_McMaster_M3 x 5mm Spacer.SLDPRT
Mechanical/SolidWorks Part Files/9397K15_McMaster_QD Terminals.SLDPRT
Mechanical/SolidWorks Part Files/9540K747_Unthreaded Bumper.SLDPRT
Mechanical/SolidWorks Part Files/9561K16_McMAster_ -015 oring.SLDPRT
Mechanical/SolidWorks Part Files/9561K24_McMaster_ -022 oring.SLDPRT
Mechanical/SolidWorks Part Files/95947A016_McMaster_M3 x 20mm standoff.SLDPRT
Mechanical/SolidWorks Part Files/95947A063_Aluminum Female Threaded Hex Standoff.SLDPRT
Mechanical/SolidWorks Part Files/95947A510_McMaster_M3 x 13mm spacer.SLDPRT
Mechanical/SolidWorks Part Files/95947A527_Aluminum Female Threaded Hex Standoff.SLDPRT
Mechanical/SolidWorks Part Files/98952A120_McMaster_M3 M-F Standoff 25mm.SLDPRT
Mechanical/SolidWorks Part Files/99186A143_Weather-Resistant EPDM Rubber Sealing Washers.SLDPRT
Mechanical/stuff/2930T55_316 Stainless Steel Wire Cloth Discs.SLDPRT
Mechanical/stuff/3645N11_Buna-N Gasket for John Perry Gasket Fittings.SLDPRT
Mechanical/stuff/5233K66_MCMASTER_PVC tubing 1_8 inch.SLDPRT
Mechanical/stuff/7395K11_McMaster_Power Switch.SLDPRT
Mechanical/stuff/8761K11_USB 3.0 Adapter.SLDPRT
Mechanical/stuff/90116A153_McMaster_M3 x 8mm Screws.SLDPRT
Mechanical/stuff/90116A155_McMaster_M3 x 10mm pan head.SLDPRT
Mechanical/stuff/90116A157_316 Stainless Steel Pan Head Phillips Screws.SLDPRT
Mechanical/stuff/91771A943_MCMASTER_#6-32_7-16 LONG.SLDPRT
Mechanical/stuff/91828A211_18-8 Stainless Steel Hex Nut.SLDPRT
Mechanical/stuff/92010A118_Passivated 18-8 Stainless Steel Phillips Flat Head Screw.SLDPRT
Mechanical/stuff/92010A122_Passivated 18-8 Stainless Steel Phillips Flat Head Screw.SLDPRT
Mechanical/stuff/9273K15_McMaster_Velcro 1_5in.SLDPRT
Mechanical/stuff/9307K73_Buna-N Rubber Grommets.SLDPRT
Mechanical/stuff/93657A207_McMaster_M3 x 5mm Spacer.SLDPRT
Mechanical/stuff/9397K15_McMaster_QD Terminals.SLDPRT
Mechanical/stuff/9540K747_Unthreaded Bumper.SLDPRT
Mechanical/stuff/9561K16_McMAster_ -015 oring.SLDPRT
Mechanical/stuff/9561K24_McMaster_ -022 oring.SLDPRT
Mechanical/stuff/95947A016_McMaster_M3 x 20mm standoff.SLDPRT
Mechanical/stuff/95947A063_Aluminum Female Threaded Hex Standoff.SLDPRT
Mechanical/stuff/95947A510_McMaster_M3 x 13mm spacer.SLDPRT
Mechanical/stuff/95947A527_Aluminum Female Threaded Hex Standoff.SLDPRT
Mechanical/stuff/98952A120_McMaster_M3 M-F Standoff 25mm.SLDPRT
Mechanical/stuff/99186A143_Weather-Resistant EPDM Rubber Sealing Washers.SLDPRT
