LoganDickon/FilterCheck/Mechanical/Interface Panel Decal/FC-007_Filter Check Decal_Peli 1400_Rev2.pdf

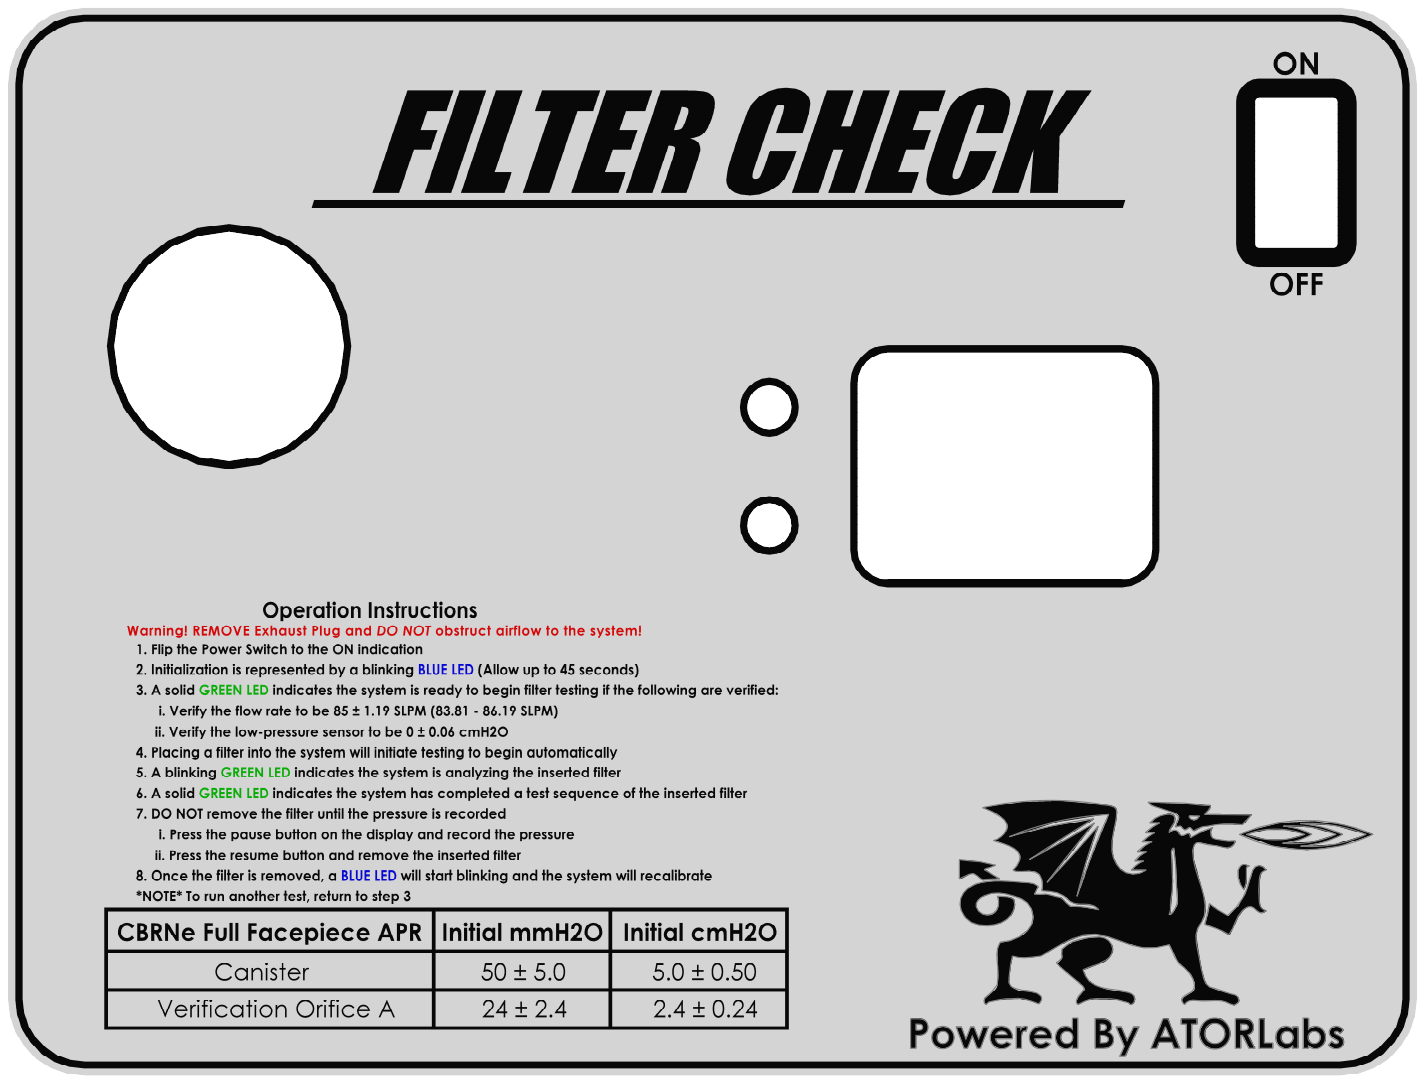
[picture p46: page 1]
