LoganDickon/FilterCheck/Electrical/Print Ready Electrical PDFs/FilterCheck - Electrical Schematics.pdf

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

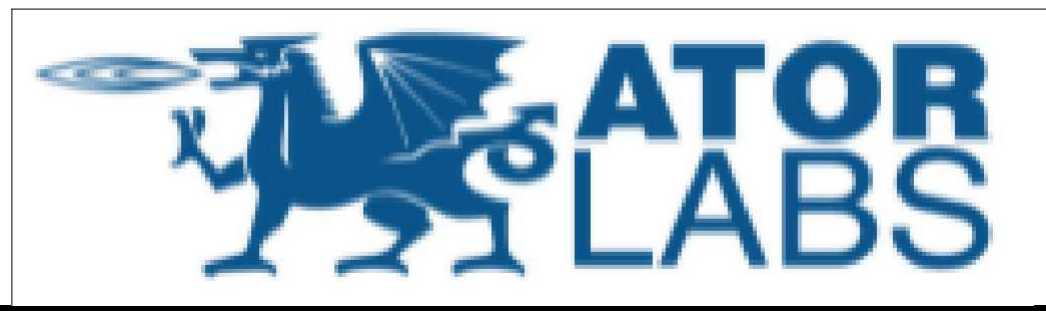
[picture p47: figure]

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

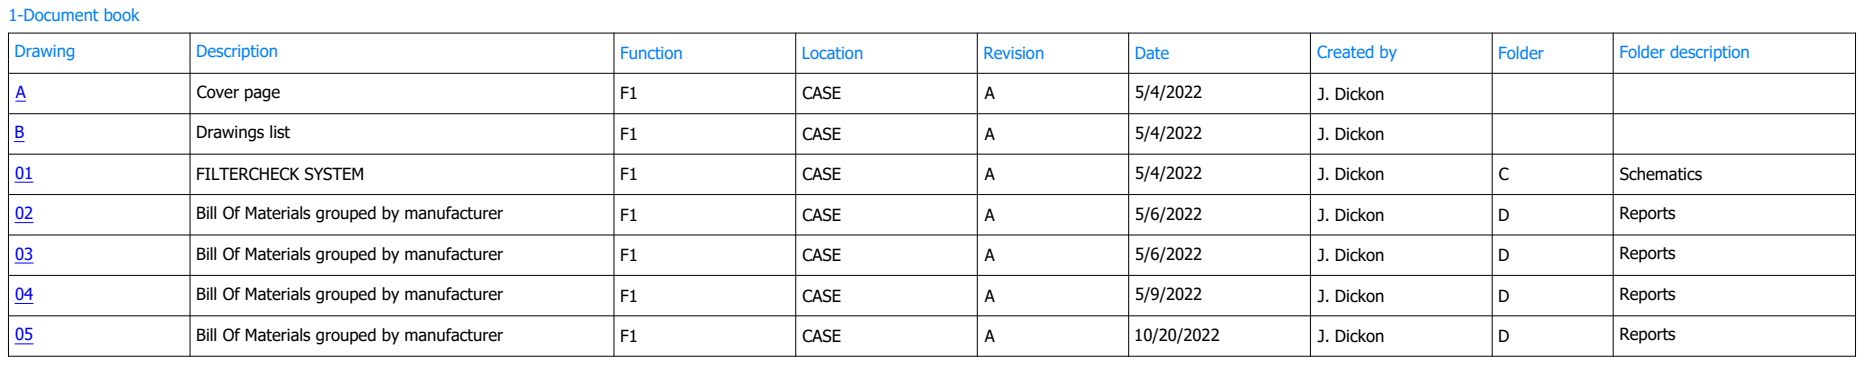
[picture p48: page 2]

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

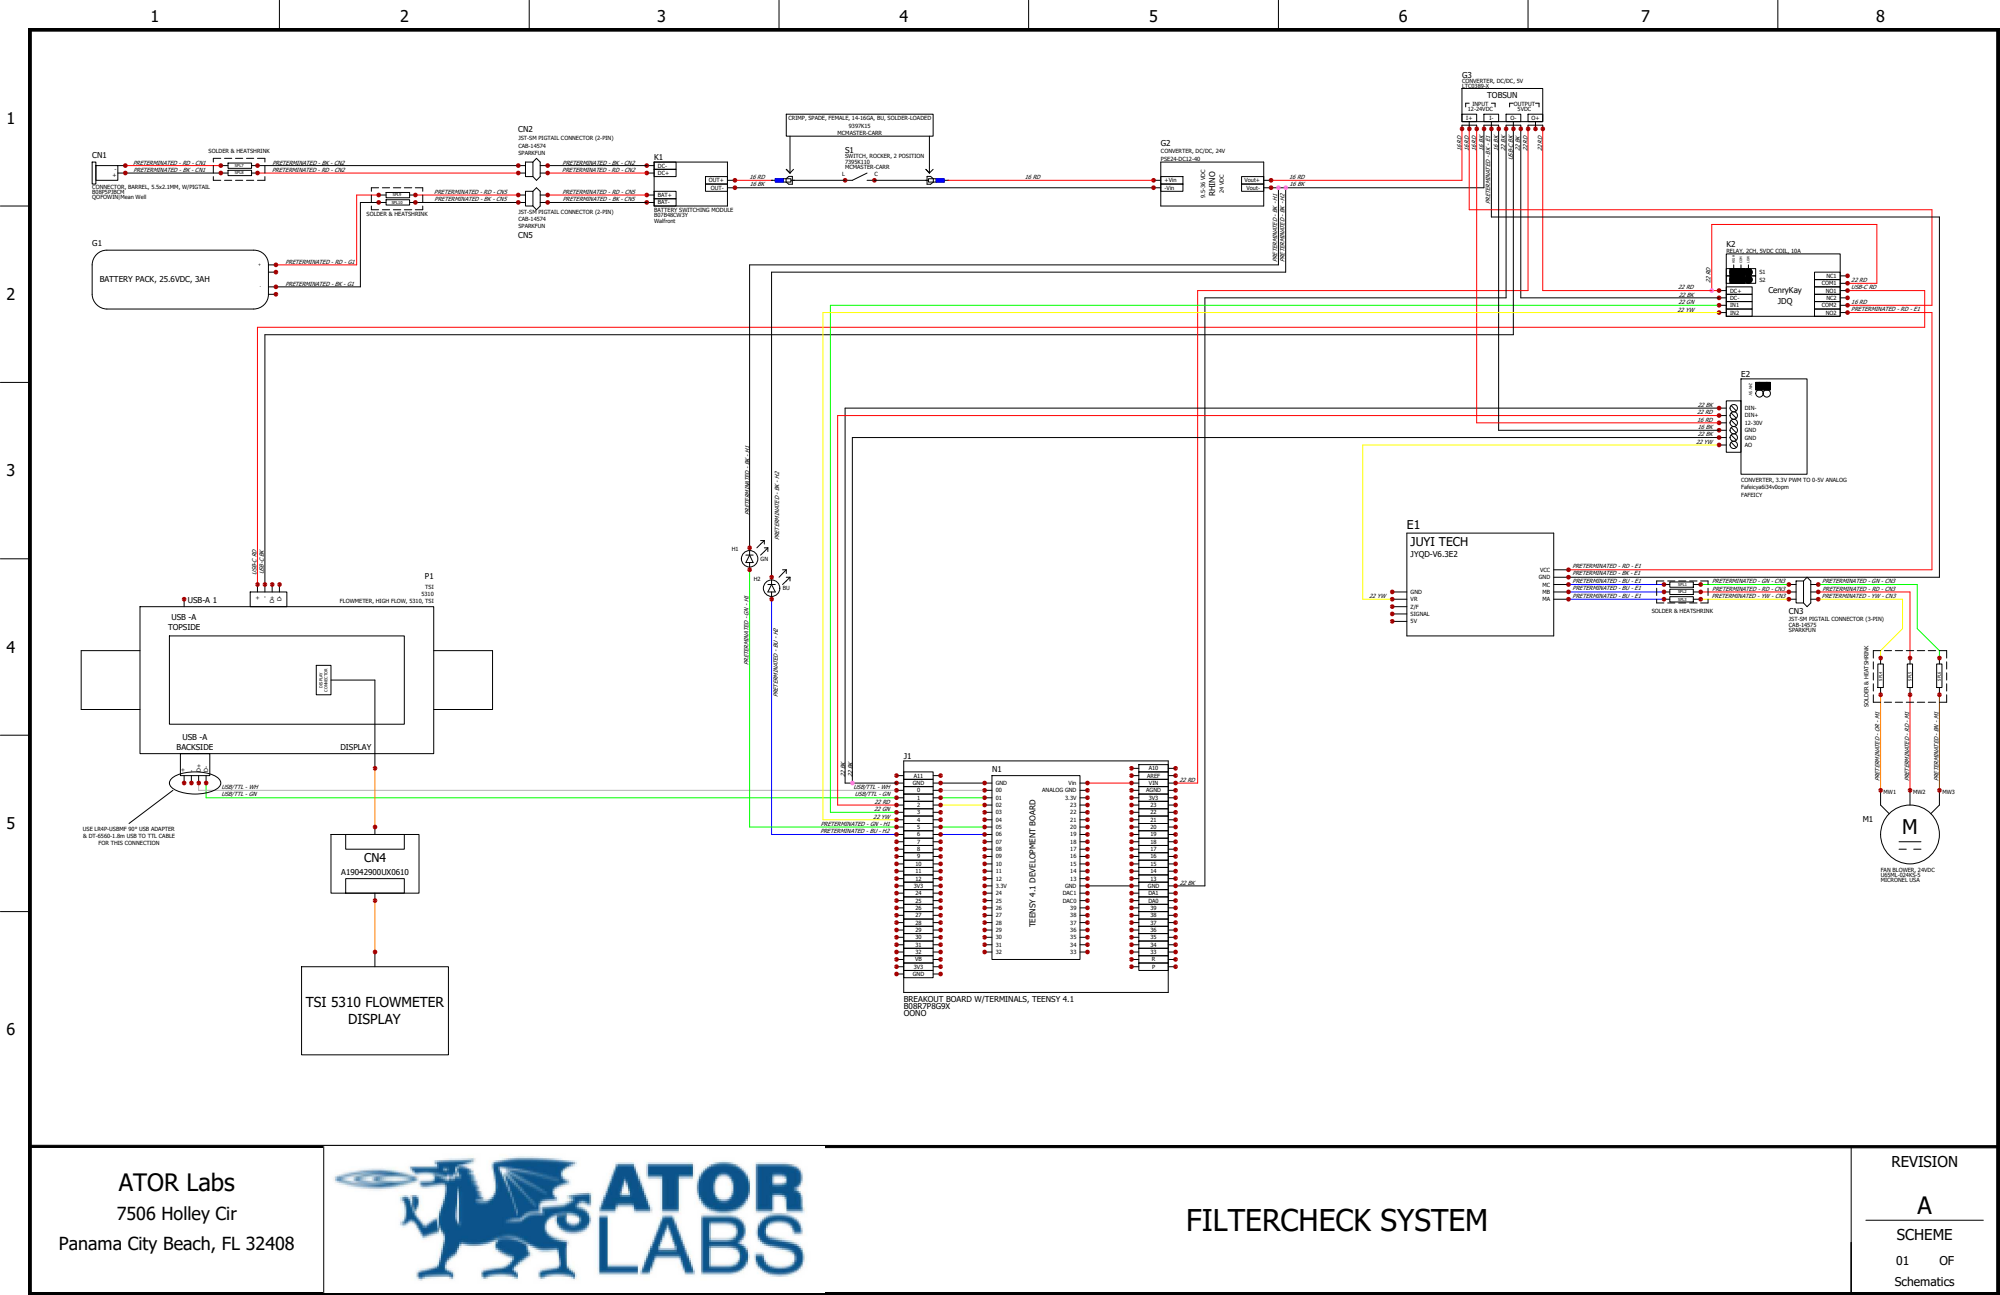
[picture p49: page 3]

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

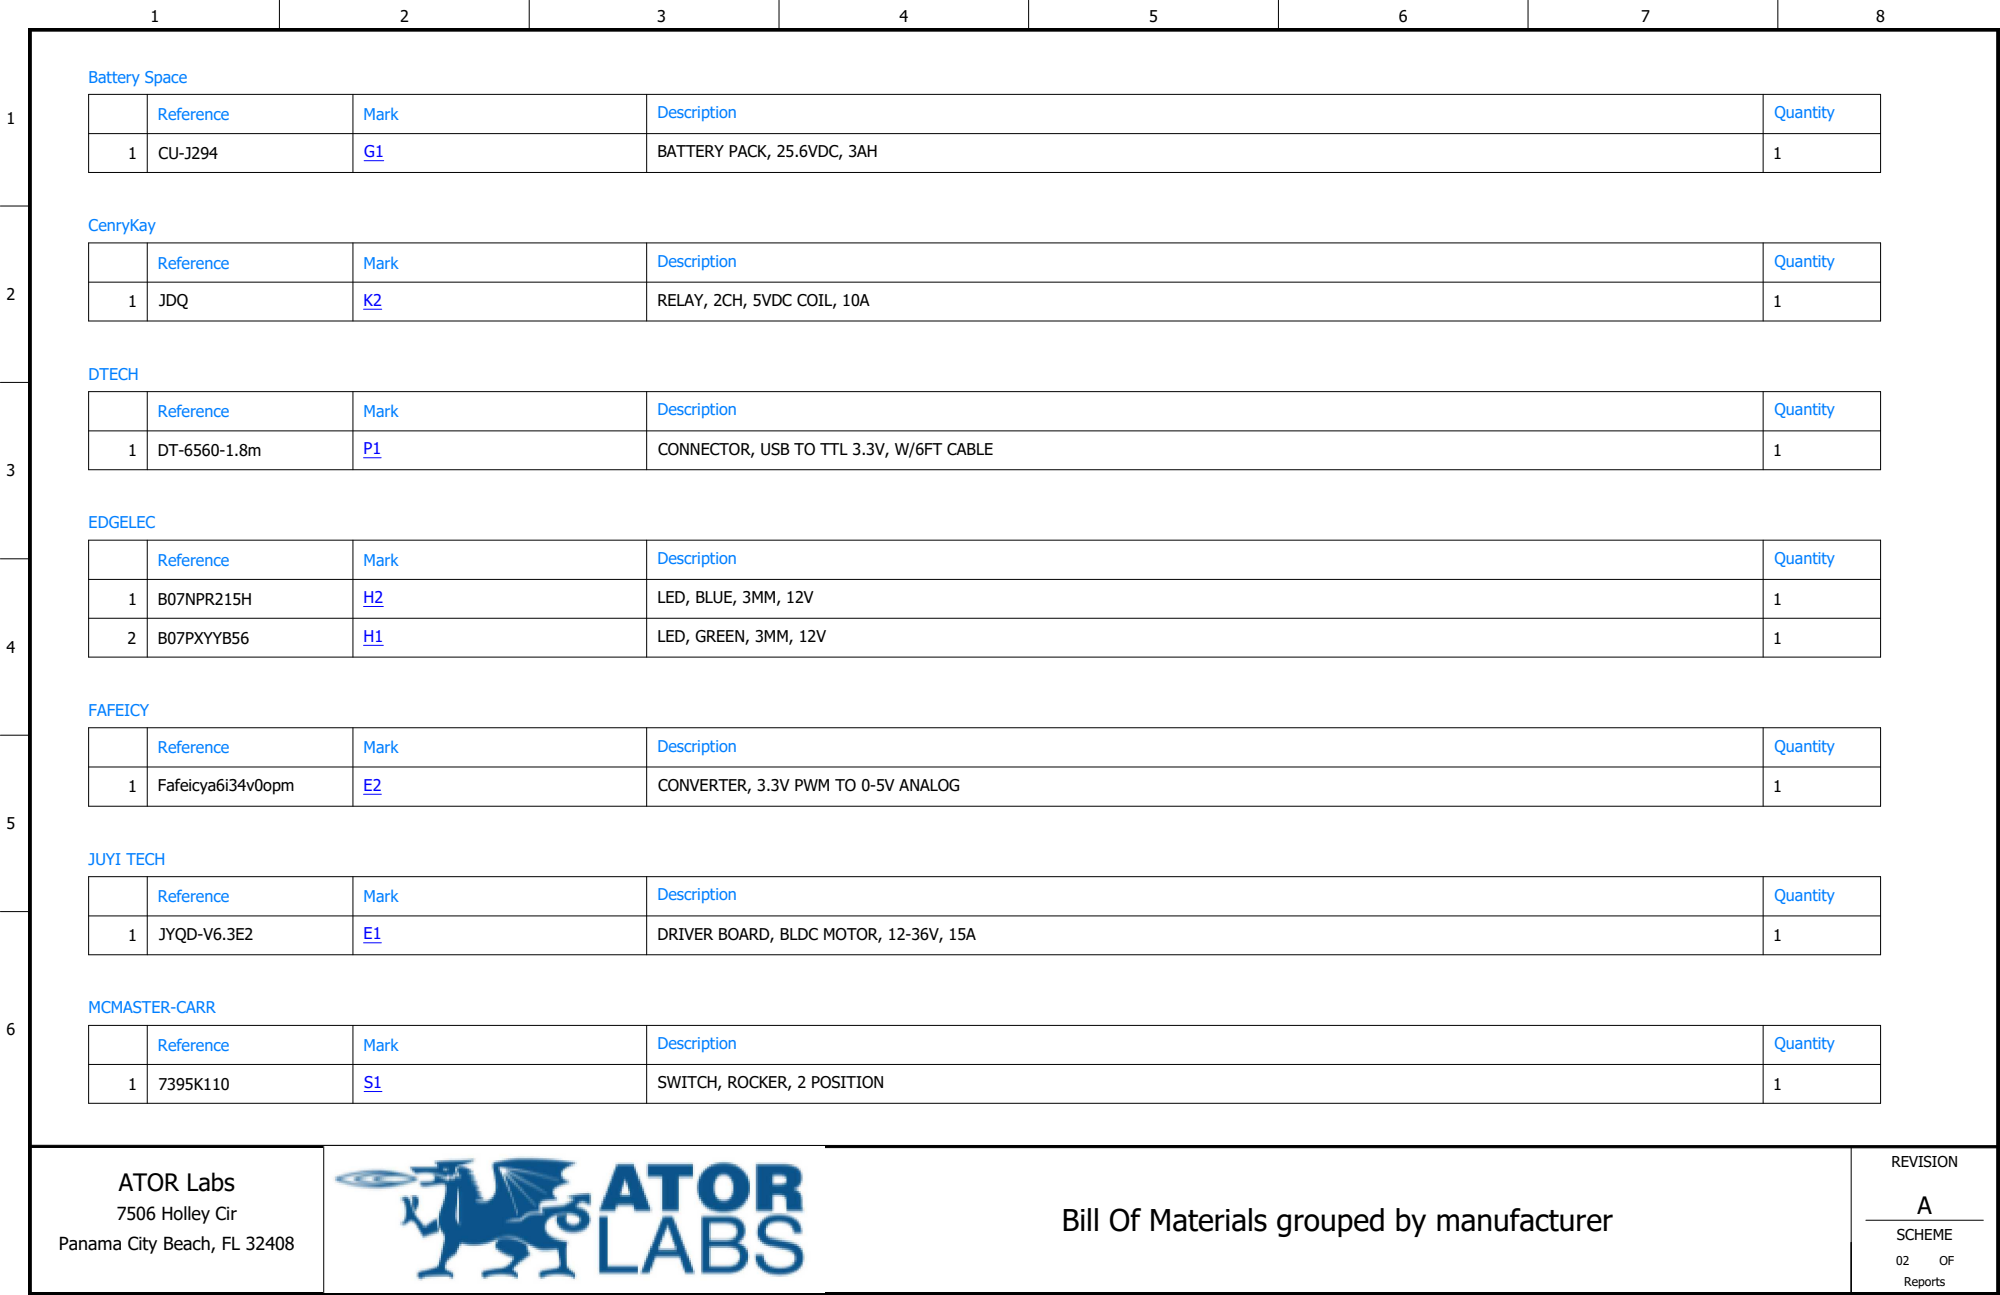
[picture p50: page 4]

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

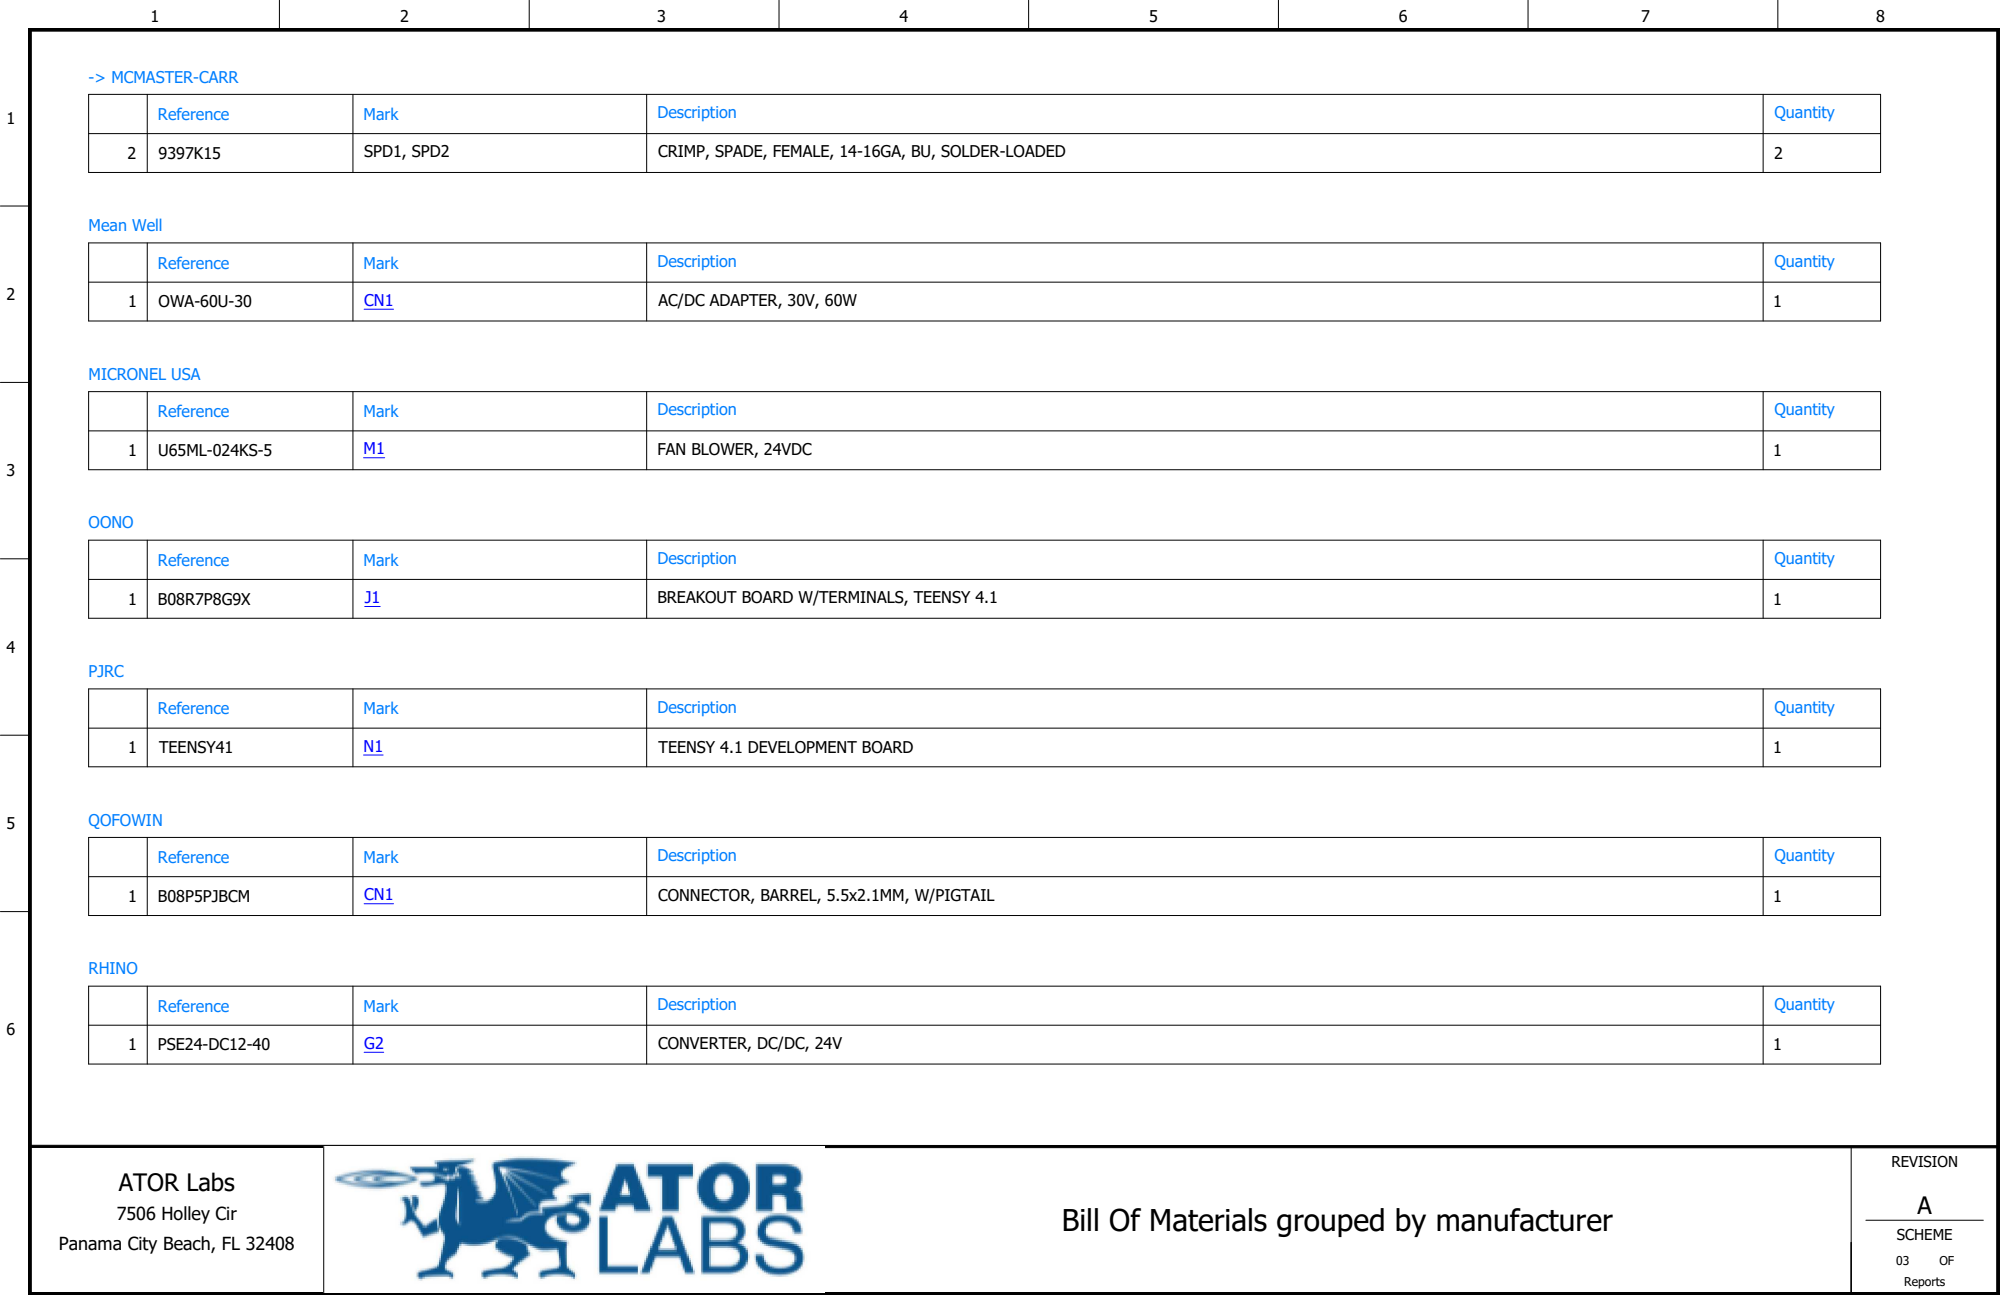
[picture p51: page 5]

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

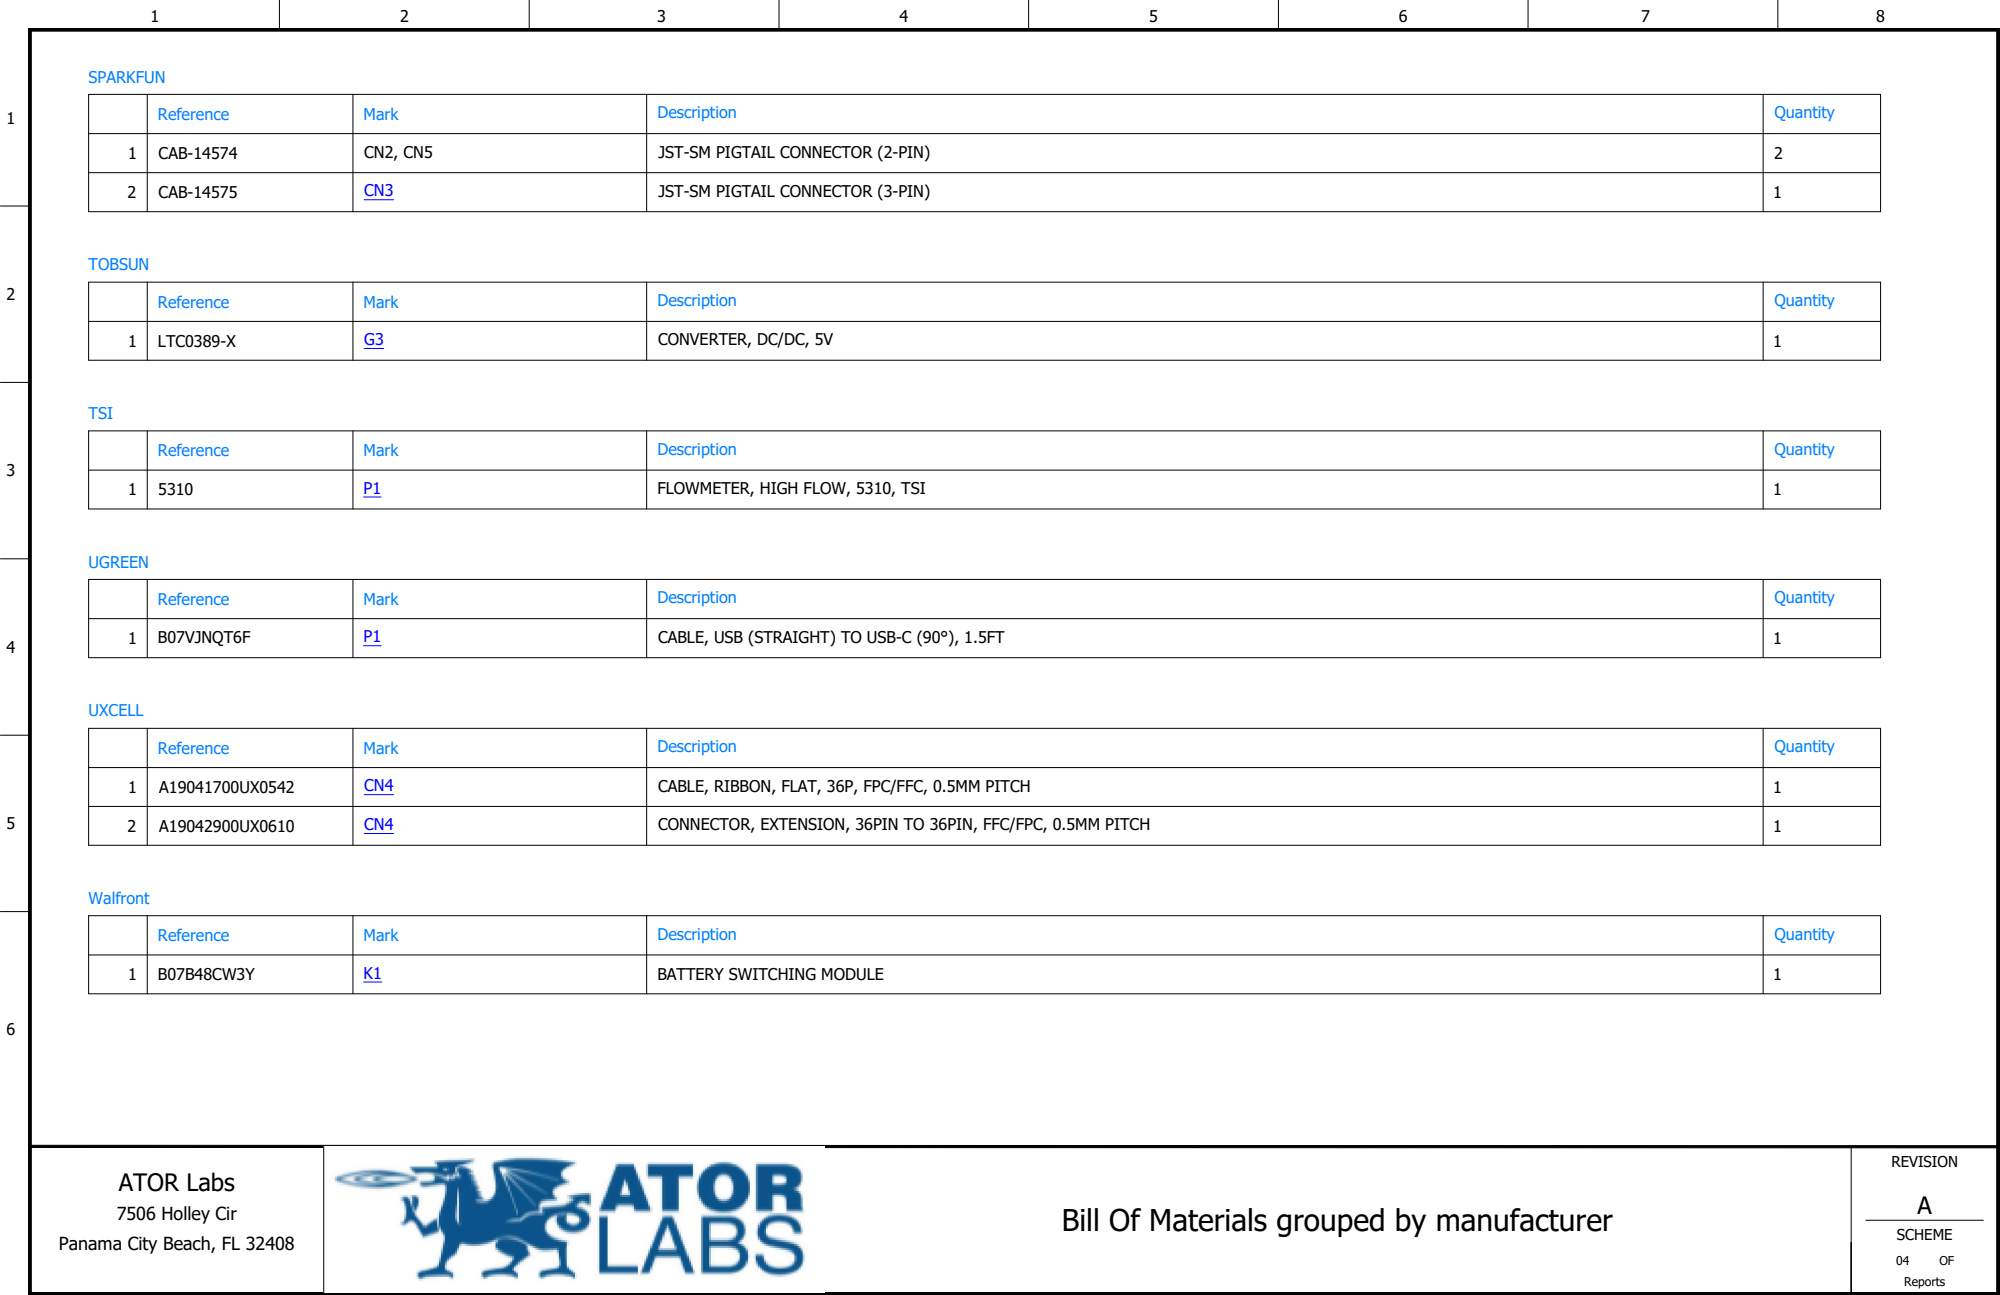
[picture p52: page 6]

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

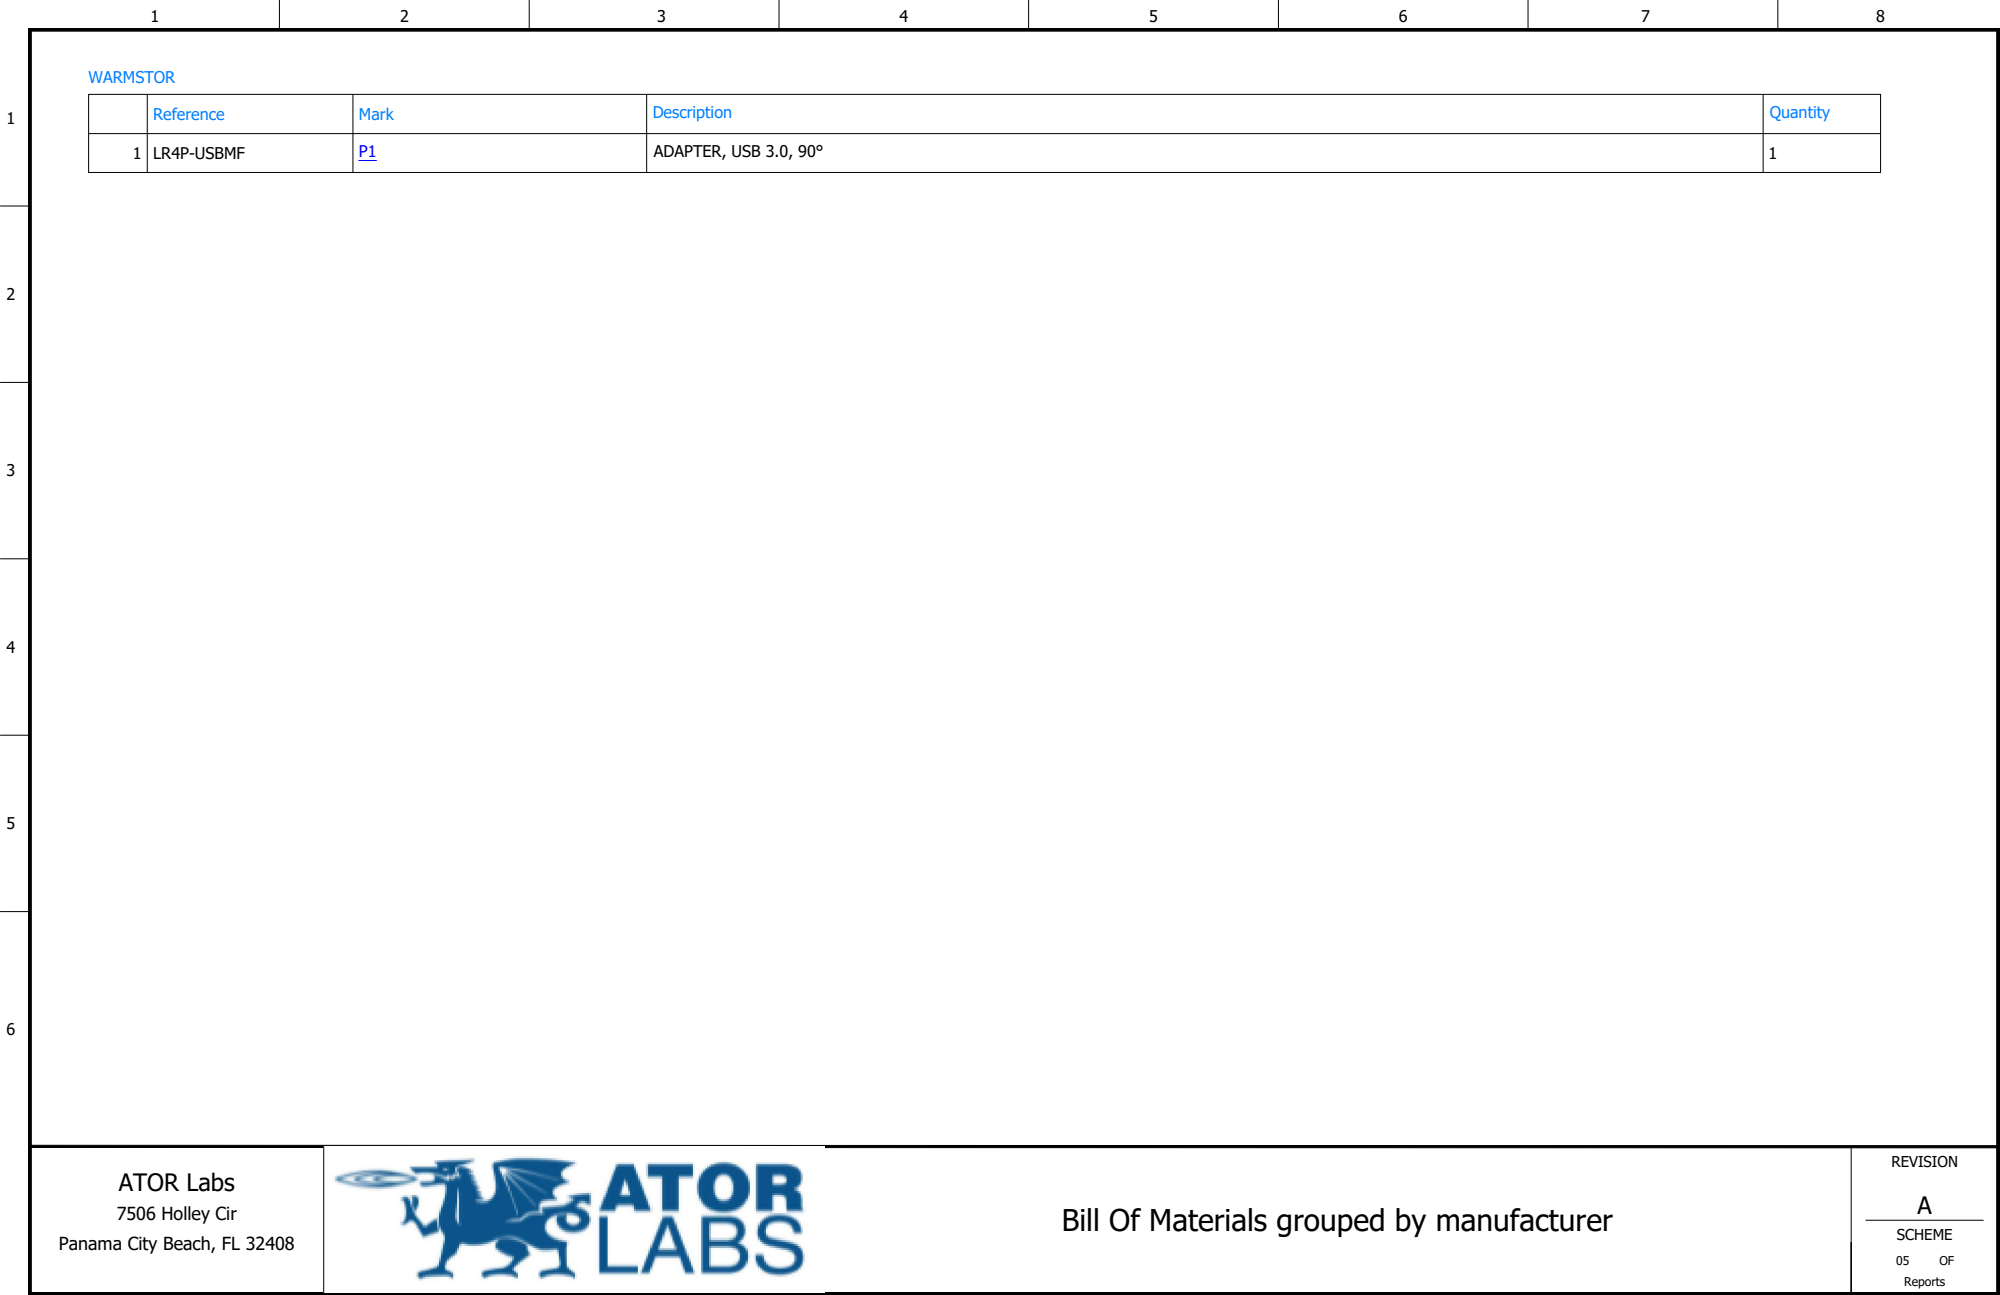
[picture p53: page 7]
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
