LoganDickon/FilterCheck/(commit log)

2022-05-03 Create Print Ready Electrical PDFs
2022-12-27 Added SolidWorks Parts
    [120V Cable End.SLDPRT, 2930T55_316 Stainless Steel Wire Cloth Discs.SLDPRT, 3645N11_Buna-N Gasket for John Perry Gasket Fittings.SLDPRT, 5233K66_MCMASTER_PVC tubing 1_8 inch.SLDPRT, 5ZSD8W-YT-12V_Chanzon_Panel Mount LED.SLDPRT, 7395K11_McMaster_Power Switch.SLDPRT, 8761K11_USB 3.0 Adapter.SLDPRT, 90116A153_McMaster_M3 x 8mm Screws.SLDPRT]
2022-12-27 Create SolidWorks Assembly Files
